MertHayla/Teknofest-tasarim-raporlari/Teknofest Raporları/OTR_Raporu.pdf

Herkese Açık | Public

# TEKNOFEST 2020 ROKET YARIŞMASI Orta İrtifa Kategorisi Ön Tasarım Raporu (ÖTR) Sunuşu

# Albedo Roket Takımı

## Takım Logosu

24 Mart 2021 Çarşamba | 1

2021 TEKNOFEST ROKET YARIŞMASI ÖN TASARIM RAPORU (ÖTR)

# Takım Yapısı Takım

## Logosu

Prof. Dr. Hasan ÇALLIOĞLU Pamukkale Üniversitesi Mekatronik Mühendisliği Bölüm Başkanı Danışman; Hüseyin Mert Arıcı Pamukkale Üniversitesi Mekatronik Mühendisliği Bölümü Takım Lideri İletişim Sorumlusu; Mustafa Kaan Kişmir Pamukkale Üniversitesi Mekatronik Mühendisliği Bölümü Mekanik Koordinatörü; Ramazan Kızılkaya Pamukkale Üniversitesi Mekatronik Mühendisliği Bölümü; Mert Hayla Pamukkale Üniversitesi Mekatronik Mühendisliği Bölümü Elektronik ve Yazılım Koordinatörü; Rıdvan Bakmış Pamukkale Üniversitesi Mekatronik Mühendisliği Bölümü

24 Mart 2021 Çarşamba | 2

2021 TEKNOFEST ROKET YARIŞMASI ÖN TASARIM RAPORU

Herkese Açık | Public Yarışma Roketi Genel

# Görünümü

## Takım Logosu

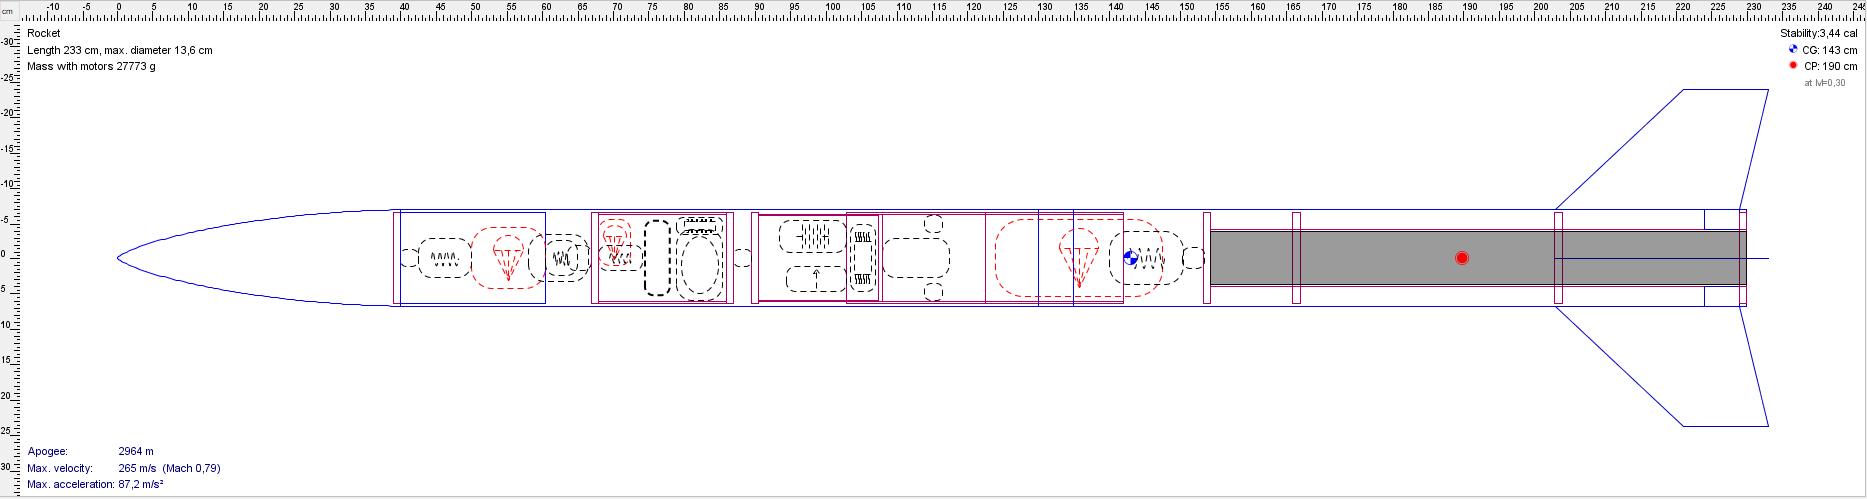
[picture p53: figure]

24 Mart 2021 Çarşamba | 3

2021 TEKNOFEST ROKET YARIŞMASI ÖN TASARIM RAPORU

# Kabul Kriterleri Özeti Takım

## Logosu

24 Mart 2021 Çarşamba | 4

## Tahmin Edilen Uçuş Verileri ve Analizleri

| Ölçü | Yorum
Boy (metre): | 2,33 | OpenRocket ana sayfasından alınmıştır.
Çap (metre): | 0,136 | OpenRocket ana sayfasından alınmıştır.
Roketin Kuru Ağırlığı(kg.): | 16,741 | Motor ve faydalı yük ağırlığı çıkarılmıştır.
Yakıt Kütlesi(kg.): | 4,349 | Motor kataloğundaki detaylardan alınmıştır.
Motorun Kuru Ağırlığı(kg.): | 2,683 | Motor kataloğundaki detaylardan alınmıştır.
Faydalı Yük Ağırlığı (kg.): | 4 | Şartname de bu şekilde belirtilmiştir.
Toplam Kalkış Ağırlığı (kg.): | 27,773 | OpenRocket ana sayfasından alınmıştır.
İtki Tipi: | Kuru Yakıt | Yarışmada kullanılan yakıt tipidir.
| Ölçü | Yorum
Kalkış İtki/Ağırlık Oranı: | 1,65 | Kalkıştaki itkinin kalkıştaki ağırlığa oranıdır.
Rampa Hızı(m/s): | 32,6 | OpenRocket simülasyon sayfasından alınmıştır.
Yanma Boyunca En az Statik Denge Değeri: | 2,29 | Simülasyon verilerinden alınmıştır.
En büyük ivme (g): | 8,899 | Maksimum ivmenin 9.81’e bölünmüş halidir.
En Yüksek Hız(m/s & M): | 265 | OpenRocket simülasyon sayfasından alınmıştır.
Belirlenen İrtifa(m): | 3000 | Yarışma şartnamesinde yer almaktadır.

## Yarışma Roketi Hakkında Genel Bilgiler

Marka : | Cesaroni | İsim: M2020 | Sınıf: | M
Motorun Toplam İtki Değeri(Ns): | | | 8429,4
Marka : | Cesaroni | İsim: M2150 | Sınıf: | M
Motorun Toplam İtki Değeri(Ns): | | | 7455,4

## Motor Seçimleri

2021 TEKNOFEST ROKET YARIŞMASI ÖN TASARIM RAPORU

# Open Rocket Genel Tasarım Takım

## Logosu

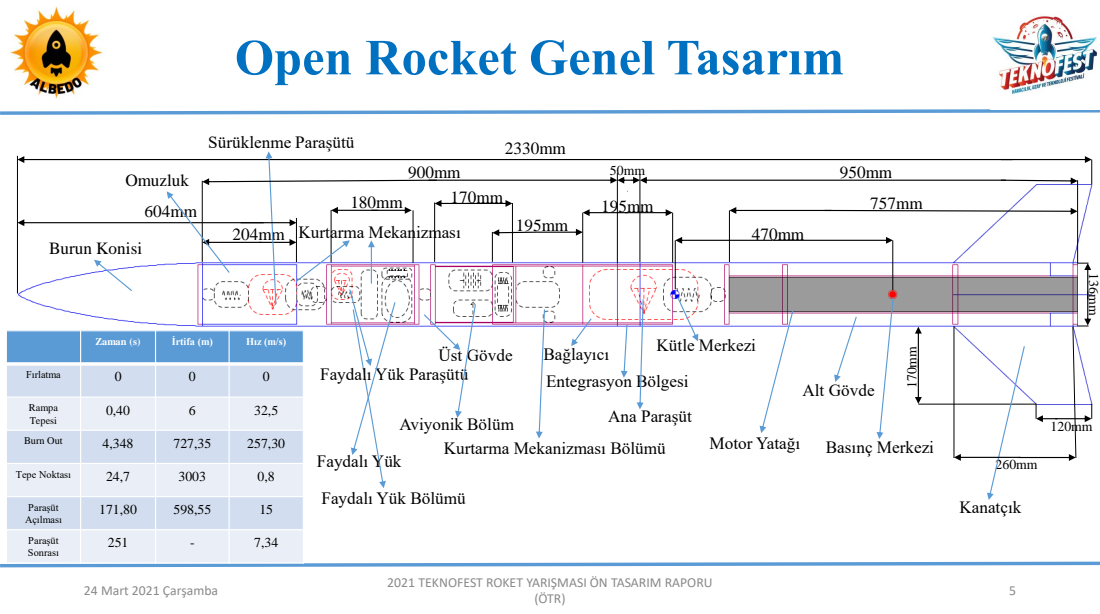
[picture p54: page 5]
24 Mart 2021 Çarşamba; Burun Konisi; Omuzluk; Üst Gövde; Entegrasyon Bölgesi; Alt Gövde; Kanatçık; Kütle Merkezi; Basınç Merkezi; Sürüklenme Paraşütü; Ana Paraşüt; Bağlayıcı; Motor Yatağı; Paraşüt Sonrası; Faydalı Yük; Kurtarma Mekanizması

Zaman (s) | İrtifa (m) | Hız (m/s)

Fırlatma | 0 | 0 | 0

Faydalı Yük Paraşütü

Rampa Tepesi | 0,40 | 6 | 32,5

Aviyonik Bölüm
Kurtarma Mekanizması Bölümü

Burn Out | 4,348 | 727,35 | 257,30

Tepe Noktası | 24,7 | 3003 | 0,8

Faydalı Yük Bölümü

Paraşüt Açılması | 171,80 | 598,55 | 15

2021 TEKNOFEST ROKET YARIŞMASI ÖN TASARIM RAPORU

# Open Rocket/Roket Tasarımı Genel Görünüm Takım

## Logosu

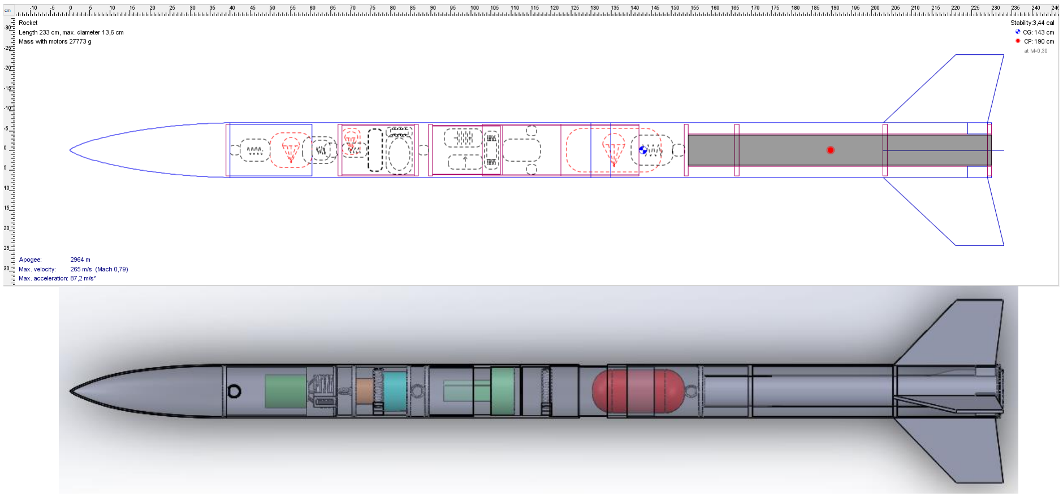
[picture p55: figure]

24 Mart 2021 Çarşamba | 6

2021 TEKNOFEST ROKET YARIŞMASI ÖN TASARIM RAPORU

# Roket Tasarımı Genel Görünüm Takım

## Logosu

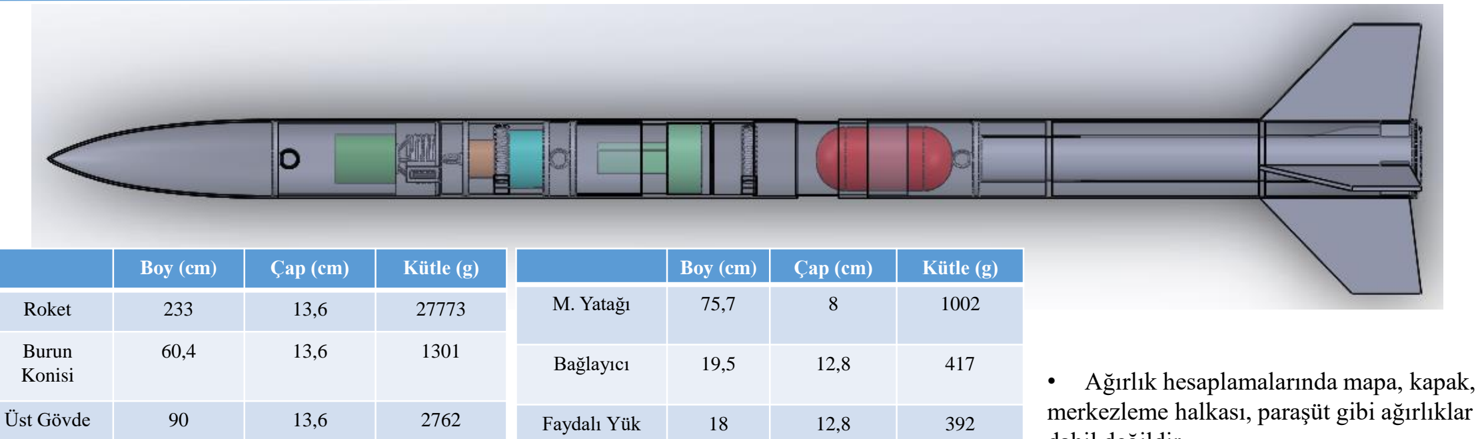
[picture p56: figure]
Boy (cm); Çap (cm); Kütle (g); Roket; Burun Konisi; Üst Gövde; M. Yatağı; Bağlayıcı; Faydalı Yük; • Ağırlık hesaplamalarında mapa, kapak, merkezleme halkası, paraşüt gibi ağırlıklar

24 Mart 2021 Çarşamba | 7

2021 TEKNOFEST ROKET YARIŞMASI ÖN TASARIM RAPORU

Entegrasyon Gövdesi | 5 | 13,6 | 148
Alt Gövde | 95 | 13,6 | 2915
Motor | 75,7 | 7,5 | 7032

Bölümü

Aviyonik Bölüm | 17 | 12,4 | 241
Kurtarma Mekanizması | 19,5 | 12,8 | 417
Kanatçık | 12/26 | 17 | 2900

dahil değildir.

# Motor Seçimi Takım

## Logosu

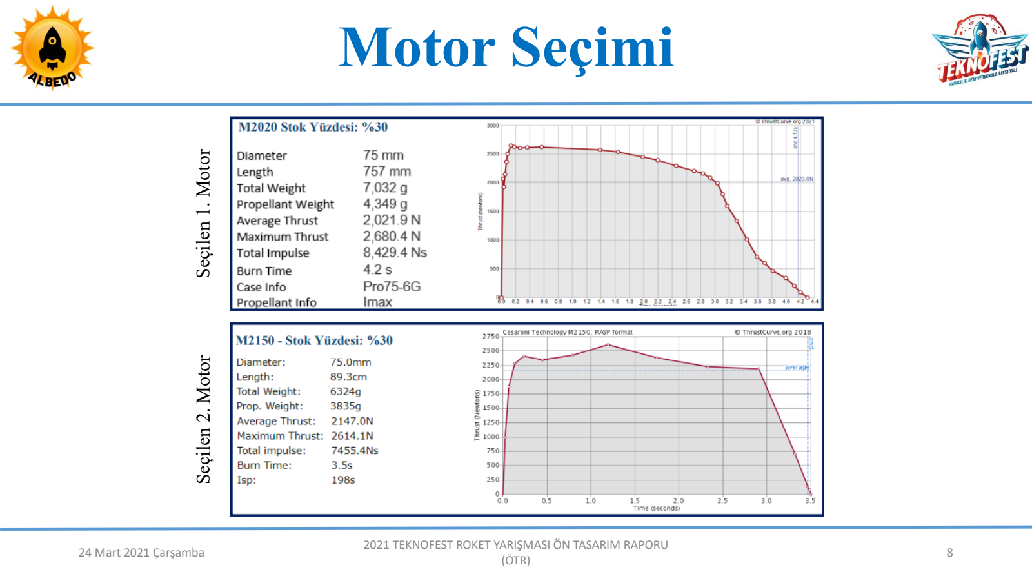
[picture p57: page 8]

24 Mart 2021 Çarşamba

8

2021 TEKNOFEST ROKET YARIŞMASI ÖN TASARIM RAPORU

### Seçilen 1. Motor Seçilen 2. Motor

# 3 Serbestlik Dereceli Uçuş Benzetimi - 1

## Takım

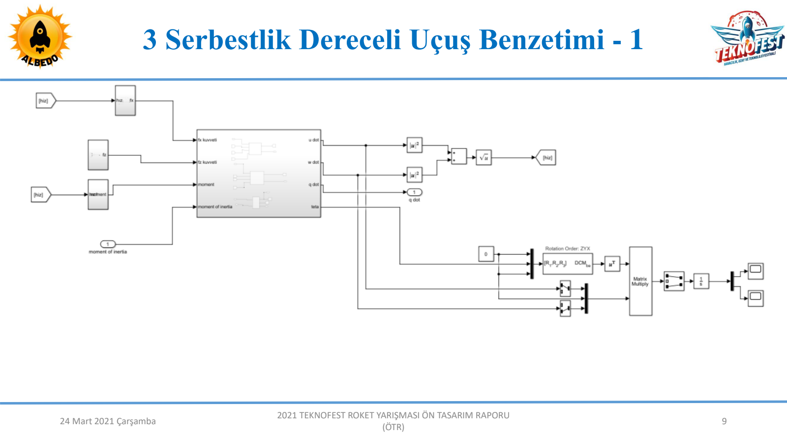
[picture p58: page 9]

## Logosu

24 Mart 2021 Çarşamba | 9

2021 TEKNOFEST ROKET YARIŞMASI ÖN TASARIM RAPORU

# 3 Serbestlik Dereceli Uçuş Benzetimi - 2

## Takım Logosu

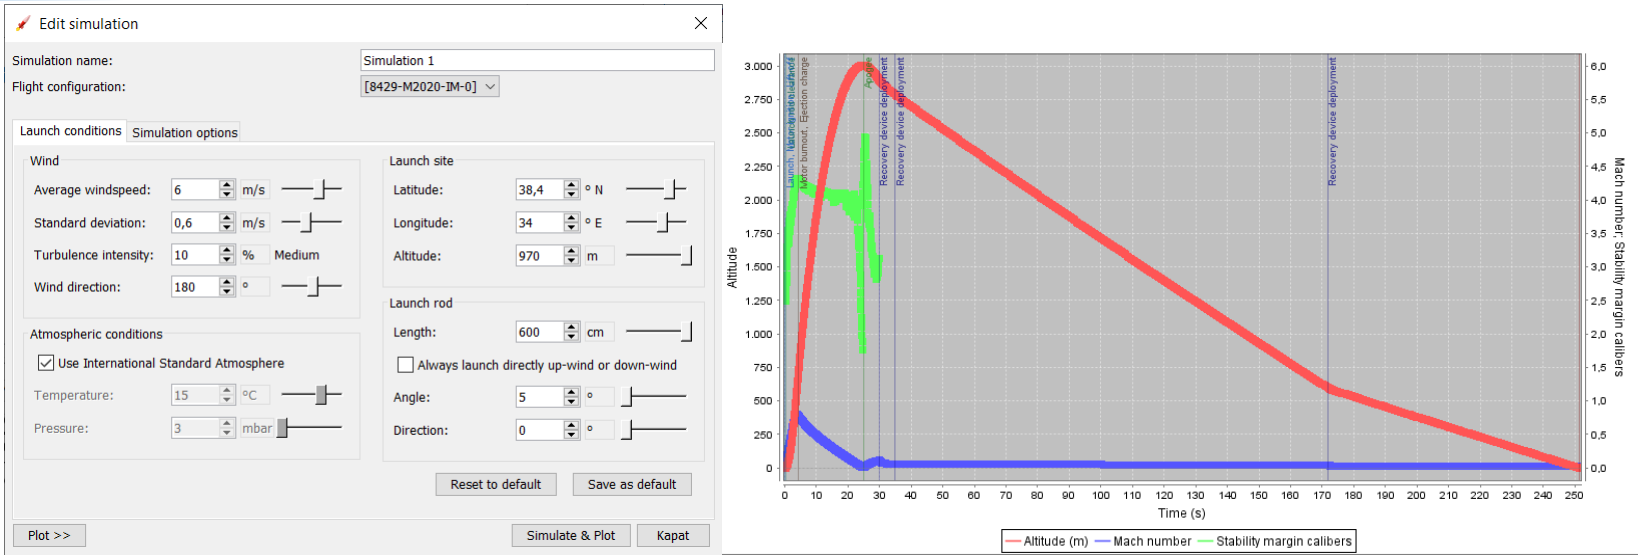
[picture p59: figure]

24 Mart 2021 Çarşamba | 10 2021 TEKNOFEST ROKET YARIŞMASI ÖN TASARIM RAPORU
- Yapılan simülasyonlar şartnamede verilen değerlerle benzetimi yapılmıştır. Değerler girildikten sonra ‘Save as default’
dememize rağmen program kapatılıp tekrar açıldığında Wind
direction, pressure ve direction değerleri değişmektedir.

### Uçuş Simülasyonu

# 3 Serbestlik Dereceli Uçuş Benzetimi - 3

## Takım Logosu

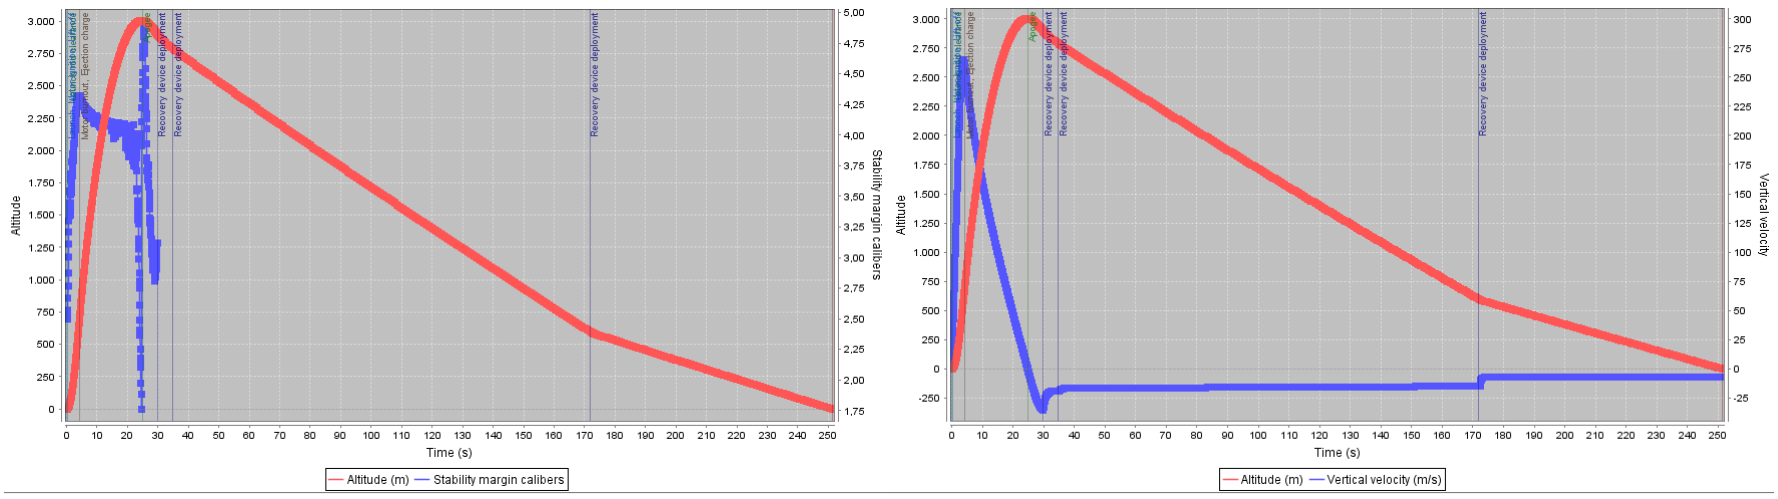
[picture p60: figure]

24 Mart 2021 Çarşamba | 11 2021 TEKNOFEST ROKET YARIŞMASI ÖN TASARIM RAPORU
İrtifa-Stabilite Marjini Simülasyonu | İrtifa-Hız Simülasyonu

## Takım Logosu

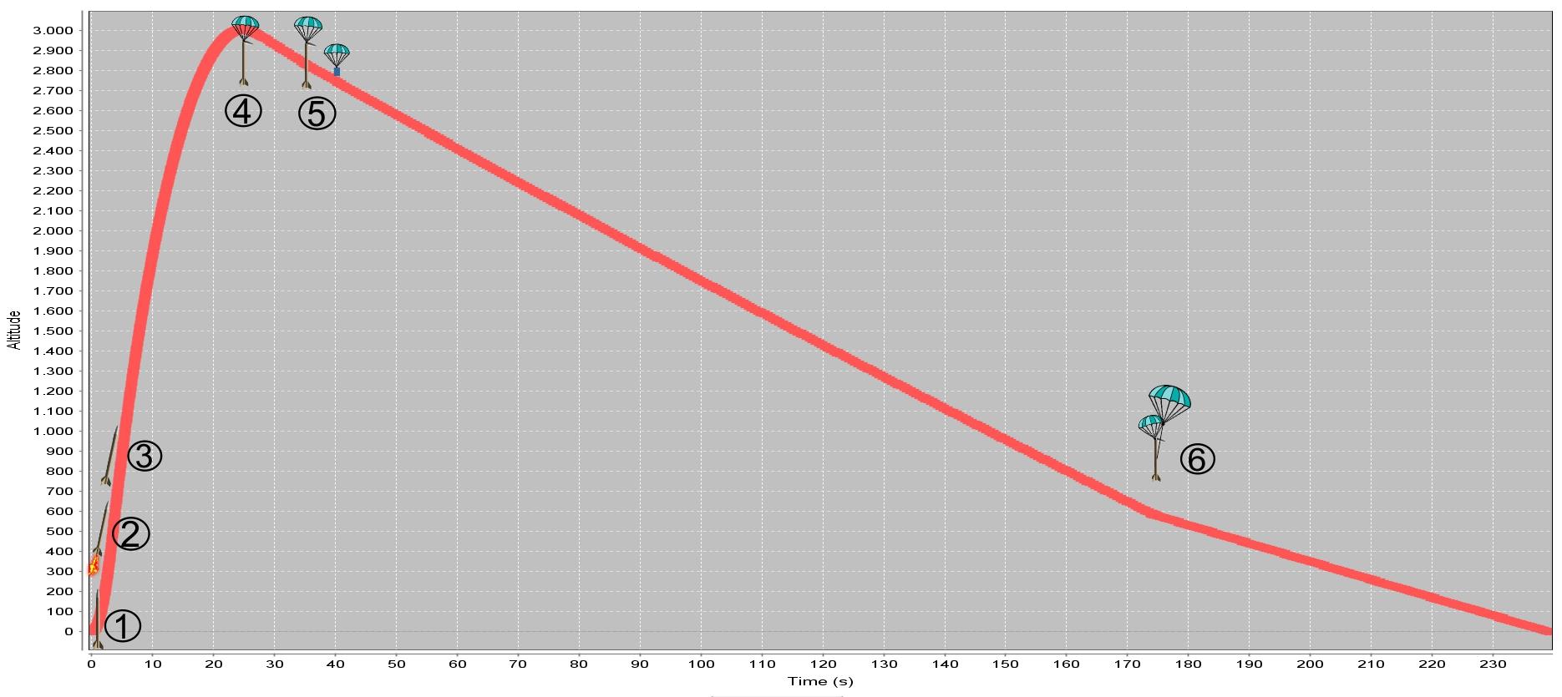
[picture p61: figure]

24 Mart 2021 Çarşamba | 12 2021 TEKNOFEST ROKET YARIŞMASI ÖN TASARIM RAPORU

# Operasyon Konsepti (CONOPS) - 1

Roketin Uçuş Süresince Yükseklik-Zaman Grafiği

| Fırlatma Süreci
1 | Roketin rampaya taşınması
2 | Roketin yakıtın yanması
3 | Roketin yakıtının bitmesi
4 | Roketin sürüklenme paraşütünün açılması
5 | Roketten faydalı yükün ayrılması
6 | Roketin ana paraşütünün açılması

# Operasyon Konsepti (CONOPS) - 2 Takım

## Logosu

24 Mart 2021 Çarşamba | 13 2021 TEKNOFEST ROKET YARIŞMASI ÖN TASARIM RAPORU

Operasyon Süreci
- Roket ilgili takım üyeleri tarafından elle taşınarak yarışma hakemlerinin belirlediği fırlatma rampasına götürülür ve rampaya yerleştirilir.
- Roket fırlatma rampasındayken aviyonik sistem düğme yardımıyla çalıştırılır.
- Yer üssünden veri akışı teyit edilir.
Görev | Görevli
Atış Sorumlusu | Mert Hayla, Hüseyin Mert Arıcı
Atış Alanı Sorumlusu | Rıdvan Bakmış, Mustafa Kaan Kişmir
İniş Alanı Sorumlusu | Ramazan Kızılkaya
- Fırlatma süreci ve uçuş evreleri operasyon konsepti – 1 sayfasında verilmiştir.
- Anlık alınan veriler yer üssündeki bilgisayarın hard diskine ve roketin içerisindeki SD karta depolanacaktır.
- Roketin fırlatma işlemi başarıyla tamamlandıktan sonra yer üssünden roketin GPS konumu anlık takip edilir. Roket inişini yaptıktan sonra iniş alanı sorumlusu yer üssü sorumlusu ile iletişime geçerek roketin konumunu saptar ve kurtarma işlemini gerçekleştirir.
- Roket rampasının eğiminin olduğu doğrultuda 1500-2000m tahmini iniş aralığıdır.

# Kütle Bütçesi Takım

## Logosu

24 Mart 2021 Çarşamba | 14 2021 TEKNOFEST ROKET YARIŞMASI ÖN TASARIM RAPORU
Kütle (g) | Adet
856 | 1
445 | 1
347 | 1
2,58 | 1
50 | 1
138 | 1
3,5 | 1
2762 | 1
50 | 1
150 | 1
300 | 1
50 | 1
347 | 1
10 | 2
112 | 1
150 | 1
150 | 2
4000 | 1
392 | 1
50 | 1
45,1 | 1
3,5 | 1
347 | 2
50 | 1
Entegrasyon Gövdesi | Gövde 148 Karbonfiber 1 Bağlayıcı 417 Alüminyum 1
Alt Gövde Motor | Gövde Fiberglass 2915 1 Mapa 50 Paslanmaz Çelik 1 Ana Paraşüt 336 Yırtılmaz Naylon 1 Ana Paraşüt Kordonu 56 Boru Şeklinde Naylon 1 Kanatçık Alüminyum 726,5 4 Motor Yatağı 1002 Alüminyum 1 Motor Kapağı 347 Alüminyum 1 Merkezleme Halkası 160 Fiberglass 2 Motor Alt Kapağı Fiberglass 238 1 Motor 7032 ? 1
Sürüklenme Paraşütü | Yırtılmaz Naylon

Roket Ürün Ağacı

Alt Sistem | Komponent | Malzeme

Burun

| Burun Konisi | Fiberglass
| Omuzluk | Fiberglass
| Kapak | Alüminyum
| Şok Kordonu | Elastik Kordon
| Mapa | Paslanmaz Çelik
| Sürüklenme Paraşütü Kordonu | Örgülü Naylon
Üst Gövde | Gövde | Fiberglass
| Mapa | Paslanmaz Çelik
Mekanizması | Kurtarma Mekanizması 1 | Fiberglass

Aviyonik Bölüm

| Aviyonik | ?
| Batarya | Endüstriyel Alkalin
| Altimetre | ?
| Kapak | Alüminyum
| Pin | ?
Kurtarma | Kapak | Fiberglass
| Kurtarma Mekanizması 2 | Fiberglass
| Faydalı Yük | Paslanmaz Çelik
| Faydalı Yük Tüpü | Fiberglass
Faydalı Yük | Faydalı Yük Aviyonik | ?
Bölümü | Faydalı Yük Paraşütü | Yırtılmaz Naylon
| Şok Kordonu | Örgülü Naylon
| Kapak | Alüminyum
| Mapa | Paslanmaz Çelik

# Roket Alt Sistem Detayları

## Takım Logosu

24 Mart 2021 Çarşamba | 15 2021 TEKNOFEST ROKET YARIŞMASI ÖN TASARIM RAPORU

# Burun Konisi & Kanatçık Mekanik Görünüm

## Takım

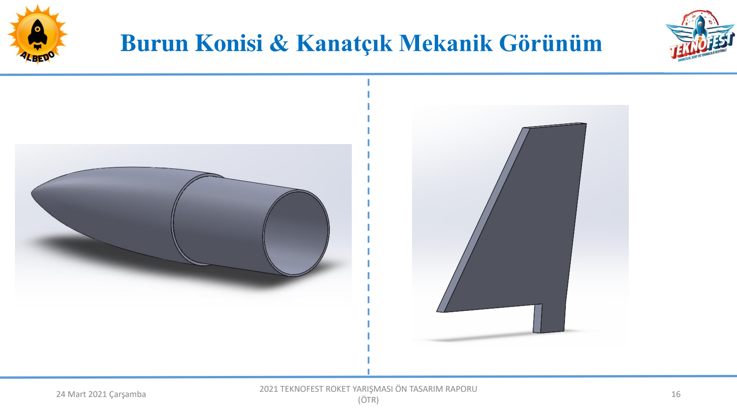
[picture p62: page 16]

## Logosu

24 Mart 2021 Çarşamba | 16 2021 TEKNOFEST ROKET YARIŞMASI ÖN TASARIM RAPORU

# Burun Konisi – Detay Takım

## Logosu

24 Mart 2021 Çarşamba | 17 2021 TEKNOFEST ROKET YARIŞMASI ÖN TASARIM RAPORU
Özellik | | Kapsam
CAD Modeli | :
Fiziksel Özellikler | : | Burun konisi şekli, seçilen burun konisinin parametreleri, boyutları, kütlesi ve burun konisinin üretileceği malzeme yandaki görselde verilmiştir.
Malzeme Bilgileri | : | Alternatif malzeme olarak karbonfiber düşünülmektedir. Değerleri tablodaki gibidir.
Malzeme | Yoğunlu k (g/cm^3) | Tokl uk | Çekme Mukavemeti (MPa) | Şekillendirileb ilirlik | Isı Dayanımı
Fiberglass | 1,85 | İyi | 3448 | Kolay | Yüksek
Karbonfiber | 1,78 | İyi | 4300 | Kolay | Yüksek
Üretim Yöntemleri | : | Prepreg dediğimiz önceden reçineye emdirilmiş hazır kumaşların kullanılmasına veya elyaf sarma yönteminin kullanılmasına karar verilmiştir.

604mm

400mm

128mm
136mm
- Üretimde fiberglass seçilmiştir çünkü malzeme dayanımı, şekillendirilebilirliği gibi faktörler göz önünde bulundurulmuştur.

Özellik | 15
CAD Modeli | : | 120mm 260mm
Fiziksel Özellikler | : | Fiberglass 1,85 3448 72,4 ²⁸mm Roket kanatçığının boyutları, kütlesi, kanatçığın üretileceği malzeme ve roket gövdesi içine girecek kısmın ölçüleri OpenRocket programından alınan görselde gözükmektedir.
Malzeme Bilgileri | : | Alternatif malzeme olarak fiberglass düşünülmektedir. Değerleri tablodaki gibidir.
Malzeme | Yoğunluk (g/cm^3) | Çekme Dayanımı (MPa) | Elastite Modülü (GPa)
Alüminyum | 2,70 | 572 | 72
Üretim Yöntemleri | :

Kanatçık tasarımı özgün üretim olmasından dolayı CAD çizimi çıkarılarak CNC kesim işleme aktarılmasıyla 8mm et kalınlığındaki alüminyum levhadan üretimi yapılması planlanmaktadır.

# Kanatçık – Detay Takım

## Logosu

24 Mart 2021 Çarşamba | 18 2021 TEKNOFEST ROKET YARIŞMASI ÖN TASARIM RAPORU

50mm

170mm

- Üretimde alüminyum tercih edilmiştir çünkü malzemenin yoğunluğu, şartname için gerekli şartları sağlamakta yardımcı olmuştur.

# Faydalı Yük Mekanik Görünüm Takım

## Logosu

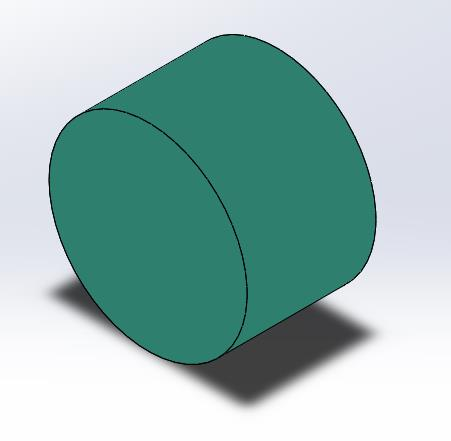
[picture p63: figure]

24 Mart 2021 Çarşamba | 19 2021 TEKNOFEST ROKET YARIŞMASI ÖN TASARIM RAPORU

# Faydalı Yük - Detay Takım

## Logosu

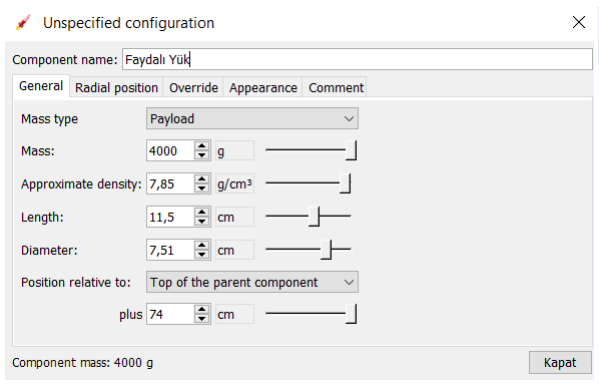
[picture p64: figure]
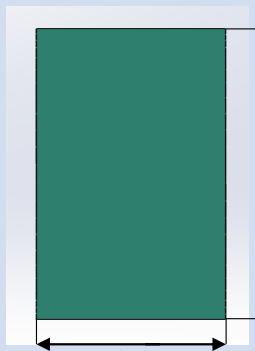
[picture p65: figure]

24 Mart 2021 Çarşamba | 20 2021 TEKNOFEST ROKET YARIŞMASI ÖN TASARIM RAPORU
Özellik | Kapsam
CAD Modeli | :
Fiziksel Özellikler | : | Faydalı yükün herhangi bir işlevi bulunmamaktadır. Faydalı yük ağırlığı, yoğunluğu ve boyutları yandaki görselde görüldüğü gibidir.
Malzeme Bilgileri | : | Roketin yoğunluğu ve boyutları baz alındığında herhangi bir alternatif malzemeye gerek duyulmamıştır. Faydalı yük üretiminde paslanmaz çelik kullanılacaktır.
Üretim Yöntemleri | : | Faydalı yükün üretimi CNC torna işleme merkezinde, paslanmaz çelik malzemeden üretimi planlanmaktadır.

Faydalı Yükün Ayrılması
Sürüklenme paraşütü açıldıktan 10 saniye sonra aviyonik sistem yay mekanizmasını devreye sokar ve faydalı yük roketten dışarı bırakılır.
Faydalı Yükün Bulunması
Faydalı yüke bağlı buzzer ve GPS yardımıyla faydalı yükün yeri tespit edilir ve kurtarılır.
Neden Paslanmaz Çelik Seçildi ?
Faydalı yük boyutlarını bu şekilde tutmak için yoğunluğuna bakılarak çelikten yapılması kararlaştırılmıştır

100mm

65mm

# Gövde Parçaları & Gövde Montaj Parçaları (YAPISAL) Mekanik Görünüm

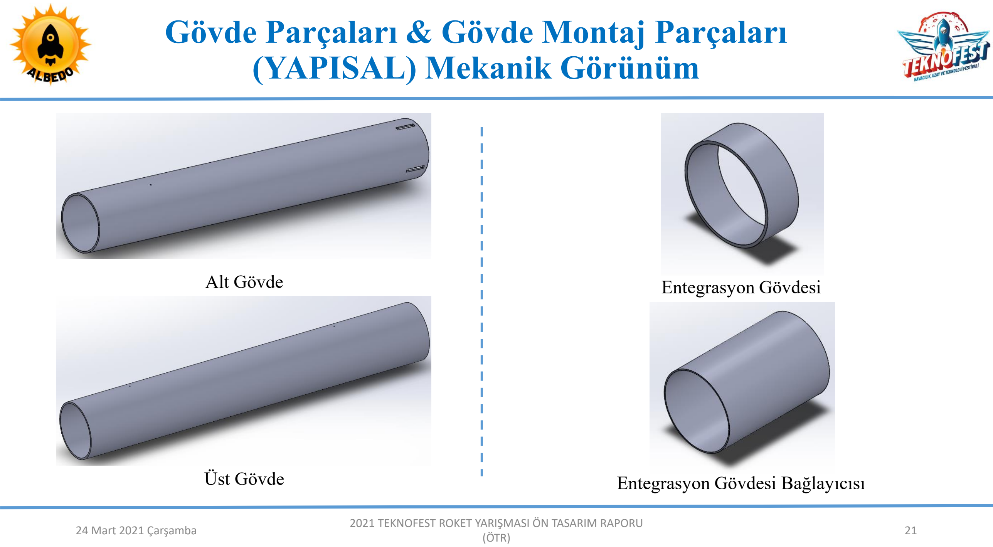
[picture p66: page 21]

## Takım Logosu

24 Mart 2021 Çarşamba | 21 2021 TEKNOFEST ROKET YARIŞMASI ÖN TASARIM RAPORU

### Alt Gövde

### Üst Gövde

### Entegrasyon Gövdesi

### Entegrasyon Gövdesi Bağlayıcısı

# Yapısal – Gövde/Gövde İçi Yapısal Destekler (Montaj Elemanları) - 1

## Takım Logosu

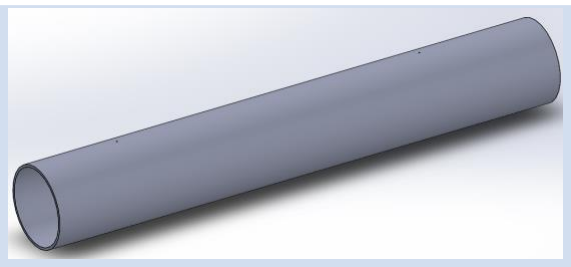
[picture p67: figure]
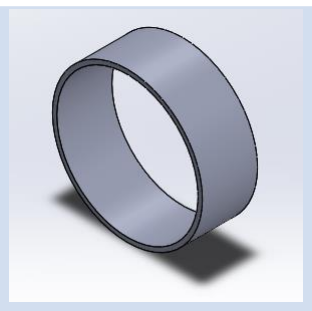
[picture p68: figure]
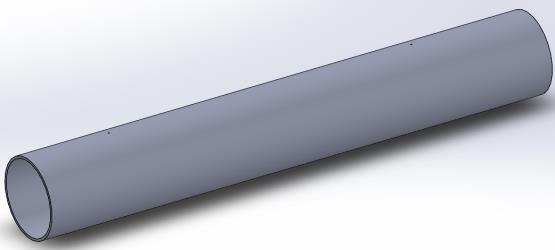
[picture p69: figure]

24 Mart 2021 Çarşamba | 22 2021 TEKNOFEST ROKET YARIŞMASI ÖN TASARIM RAPORU
Özellik | | Kapsam
CAD Modeli | :
Fiziksel Özellikler | : | Roket gövdesi, üst gövde, entegrasyon gövdesi ve alt gövdeden oluşmaktadır. Üst gövde 900mm uzunluğa, 136mm dış çapa, 4mm et kalınlığına sahiptir ve kütlesi 2,762 kg’dır. Entegrasyon gövdesi 50mm uzunluğa, 136mm dış çapa, 4mm et kalınlığına sahiptir ve kütlesi 0,148 kg’dır. Alt gövde ise 950mm uzunluğa, 136mm dış çapa, 4mm et kalınlığına sahiptir ve kütlesi 2,915 kg’dır.
Malzeme Bilgileri | : | Üst ve alt gövde için fiberglass, entegre gövdesi üretimi için karbonfiber malzeme kullanılacaktır. Malzemeler şartnamede belirtildiği gibi kompozit malzemelerden seçilmiştir. Malzemelerin bu şekilde seçilmesinin bir diğer nedeni ise roketin stabil bir şekilde uçuşunu sağlamaktadır. Kompozit malzemeler kolay şekillendirilebilir, dayanıklı, hafif ve tasarım kolaylığı olan
| (g/cm^3) | Tokluk | Çekme Mukavemeti (MPa) | Şekillendirilebilirlik | Isı Dayanımı
Fiberglass | 1,85 | İyi | 3448 | Kolay | Yüksek
Karbonfiber | 1,78 | İyi | 4300 | Kolay | Yüksek

malzemelerdir.

Üretim
Yöntemleri :

Prepreg dediğimiz önceden reçineye emdirilmiş hazır kumaşların kullanılmasına veya elyaf sarma yönteminin kullanılmasına karar verilmiştir.

- | Roketimizde | basınç
sensöründen verimli bir veri almak için her biri 3mm çapa sahip 3 tane delik açılmıştır.
Bunlardan | biri | burundan
hemen | önceki | gövdenin
bitim yerine, diğeri aviyonik sistemlerin olduğu yere ve
son | olarak | da | motor
kapağının bulunduğu yere
delikler açılmıştır.
- | Roket | motoru, | motor
yatağının | içine | girerek
montajlanacaktır. | Motor
yatağını | sabitleyen eleman
merkezleme | halkası
olacaktır. | Malzeme | Yoğunluk

# Yapısal – Gövde/Gövde İçi Yapısal Destekler (Montaj Elemanları) - 2

## Takım Logosu

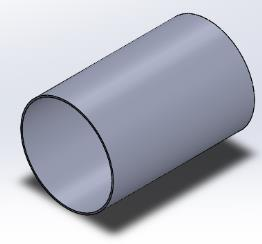
[picture p70: figure]
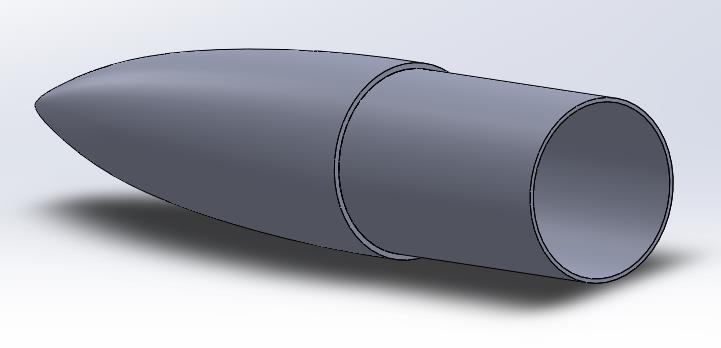
[picture p71: figure]
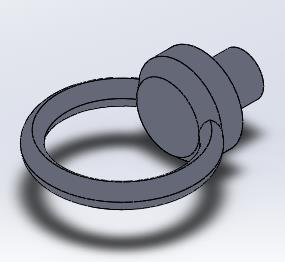
[picture p72: figure]

24 Mart 2021 Çarşamba | 23 2021 TEKNOFEST ROKET YARIŞMASI ÖN TASARIM RAPORU
Özellik | | Kapsam
CAD Modeli | :
Fiziksel Özellikler | : | Entegrasyon gövde bağlayıcısı 195mm uzunluğa, 124mm dış çapa, 2mm et kalınlığına ve 0,417 kg ağırlığa sahiptir. Burun konisi omuzluğu 204mm uzunluğa, 128mm dış çapa, 3mm et kalınlığına ve burun ile birlikte toplam 1,301 kg ağırlığa sahiptir. Merkezleme halkası 11mm uzunluğa, 128mm dış çapa, 24mm et kalınlığına ve 0,160 kg ağırlığa sahiptir. Mapa dövülmüş çelikten , şartnameye göre imal edilecektir.
Malzeme Bilgileri | : | Entegrasyon gövdesi bağlayıcısı üretimi için alüminyum malzeme, burun konisi omuzluğu üretimi için burun konisi ile aynı malzeme yani fiberglasstan ve merkezleme halkası üretimi için de fiberglass tercih edilmiştir. Üretiminin kolay olması, dayanıklı olmaları ve roket stabilitesini sağlamaları nedeniyle malzeme seçimi bu şekilde yapılmıştır.
Malzeme | Yoğunluk (g/cm^3) | Tokluk | Çekme Mukavemeti (MPa) | Şekillendirilebilirlik | Isı Dayanımı
Alüminyum | 2.7 | İyi | 572 | Kolay | Orta
Fiberglass | 1.85 | İyi | 3448 | Kolay | Yüksek
Üretim Yöntemleri | : | Üretimi kompozit malzemeden olacak parçalar için prepreg dediğimiz önceden reçineye emdirilmiş hazır kumaşların kullanılmasına veya elyaf sarma yönteminin kullanılmasına karar verilmiştir. Üretimi alüminyum malzemeden olan parçalar için CNC torna işleme merkezinde üretimi yapılacaktır.

# Yapısal – Gövde/Gövde İçi Yapısal Destekler (Montaj Elemanları) - 3

## Takım Logosu

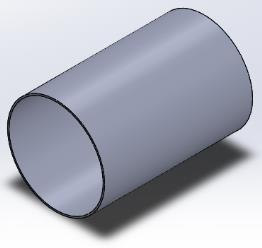
[picture p73: figure]
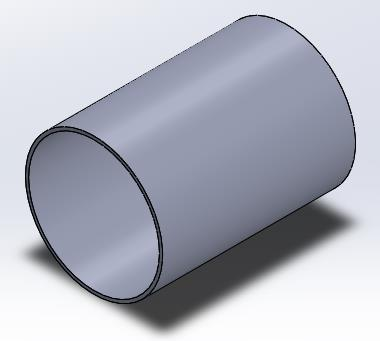
[picture p74: figure]
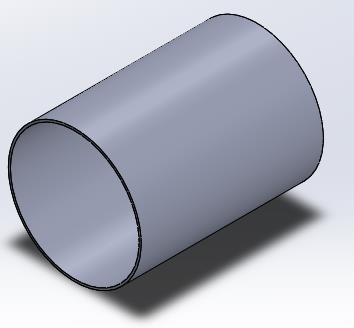
[picture p75: figure]

24 Mart 2021 Çarşamba | 24 2021 TEKNOFEST ROKET YARIŞMASI ÖN TASARIM RAPORU
Özellik | | Kapsam
CAD Modeli | :
Fiziksel Özellikler | : | Faydalı yük tüpü 180mm uzunluğa, 128mm dış çapa, 3mm et kalınlığına ve 0,392 kg ağırlığa sahiptir. Aviyonik kısım 170mm uzunluğa, 124mm dış çapa, 2mm et kalınlığına ve 0,241 kg ağırlığa sahiptir. Açılma mekanizması 195mm uzunluğa, 128mm dış çapa, 2mm et kalınlığına ve 0,417 kg ağırlığa sahiptir.
Malzeme Bilgileri | : | Faydalı yük tüpü üretimi için fiberglass malzeme, aviyonik kısım üretimi için fiberglasstan ve açılma mekanizması üretimi için ise alüminyum tercih edilmiştir. Üretiminin kolay olması, dayanıklı olmaları ve roket stabilitesini sağlamaları nedeniyle malzeme seçimi bu şekilde yapılmıştır.
Malzeme | Yoğunluk (g/cm^3) | Tokluk | Çekme Mukavemeti (MPa) | Şekillendirilebilirlik | Isı Dayanımı
Alüminyum | 2.7 | İyi | 572 | Kolay | Orta
Fiberglass | 1.85 | İyi | 3448 | Kolay | Yüksek

Üretim Yöntemleri

:

Üretimi kompozit malzemeden olacak parçalar için prepreg dediğimiz önceden reçineye emdirilmiş hazır kumaşların kullanılmasına veya elyaf sarma yönteminin kullanılmasına karar verilmiştir. Üretimi alüminyum malzemeden olan parçalar için CNC torna işleme merkezinde üretimi yapılacaktır.

# Motor Bölümü Mekanik Görünüm & Detay

## Takım Logosu

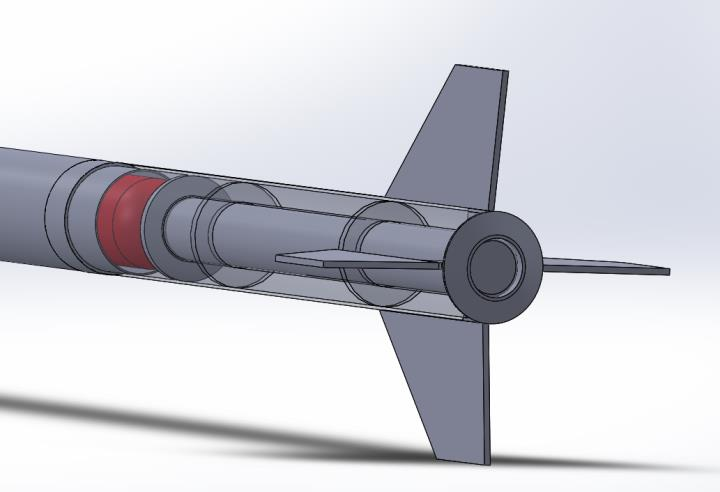
[picture p76: figure]
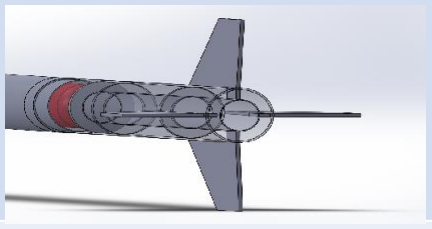
[picture p77: figure]

24 Mart 2021 Çarşamba | 25 2021 TEKNOFEST ROKET YARIŞMASI ÖN TASARIM RAPORU
Özellik | Kapsam
CAD Modeli | :

Yandaki CAD görselinde motor kısmı görülmektedir. Hakemler tarafından bize verilecek olan motor için 80mm çapında bir motor yatağı bulunmaktadır. Görsel de de görüldüğü üzere motor arka kapağı çıkarıldığında direkt motor yatağı başlamaktadır. Motor yatağına yerleştirildikten sonra motor kapağı yerine monte edilir ve roket motorunun hareket etmesi engellenir ve olası bir kazanın önünne geçilmiş olur. Alttaki görsel de de motor kapağı ve motor çıkarılmıştır.

Fiziksel Özellikler | : | Motor yatağı 80mm dış çapa sahiptir. 2mm et kalınlığından oluşan motor yatağının alüminyumdan üretilmesi planlanmaktadır. Motor yatağı merkezleme halkaları ile birlikte yerine sabitlenmiştir. Motor kapağının iç çapı 72mm olarak üretimi planlanmaktadır. Bu şekilde üretilecek bir kapak, roket motorunun motor yatağında sabit kalmasını sağlayacaktır. Motor yatağı, motor, alt gövde, motor ön ve arka kapağının toplam ağırlığı 11,854 kg’dır.
Malzeme Bilgileri | : | Roketin bu kısmında alt gövde fiberglass, motor yatağı alüminyum, merkezleme halkaları fiberglass, motor ön kapağı alüminyum, motor arka kapağı fiberglass malzemeden üretimi planlanmaktadır.
Üretim Yöntemleri | :

Üretimi kompozit malzemeden olacak parçalar için prepreg dediğimiz önceden reçineye emdirilmiş hazır kumaşların kullanılmasına veya elyaf sarma yönteminin kullanılmasına karar verilmiştir. Üretimi alüminyum malzemeden olan parçalar için CNC torna işleme merkezinde üretimi yapılacaktır.

# Motor Bölümü Mekanik Görünüm & Detay

## Takım Logosu

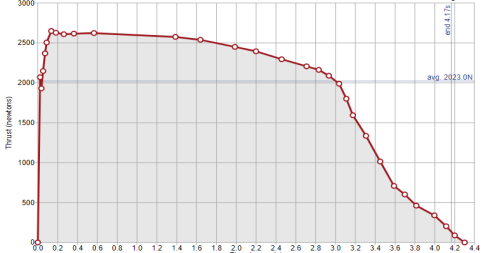
[picture p78: figure]

24 Mart 2021 Çarşamba | 26 2021 TEKNOFEST ROKET YARIŞMASI ÖN TASARIM RAPORU

Motor İtki-Zaman Grafiği

Time (s)

# İkinci/Alternatif Motor Seçimi Takım

## Logosu

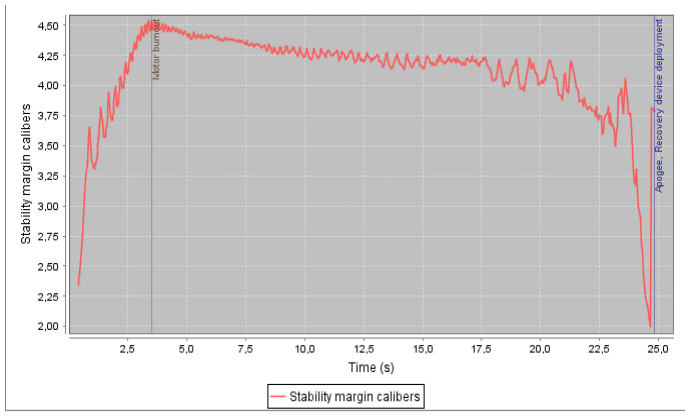
[picture p79: figure]
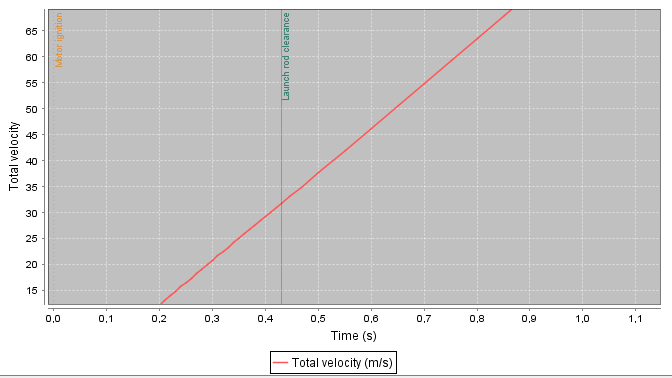
[picture p80: figure]

24 Mart 2021 Çarşamba | 27 2020 TEKNOFEST ROKET YARIŞMASI KRİTİK TASARIM RAPORU
(KTR)
- İkinci/Alternatif motor seçimi olarak M2150 motoru seçilmiştir.
- İlk seçilen M2020 motoruyla çapları aynıdır fakat M2150 motoru uzunluğu 89,3cm iken 75,7cm’dir.
Bu nedenle motor yatağı uzunluğu değişmek zorunda kalmış ve buna bağlı olarak roket içi yerleşimi biraz daha
ön tarafa doğru kaymıştır.
- M2150 için tasarlanan roketteki burun konisi ve kanatçığında geometrik değişiklikler yapıldı.
- Rokette bulunan bazı kapakların malzeme türünde değişikliğe gidildi ve roketin az bir miktar hafifletilmesi sağlandı.
- Statik marjin ve rampadan çıkış hızıyla ilgili grafikler alt tarafta verildiği gibidir.

# Kurtarma Sistemi Mekanik Görünüm Takım

## Logosu

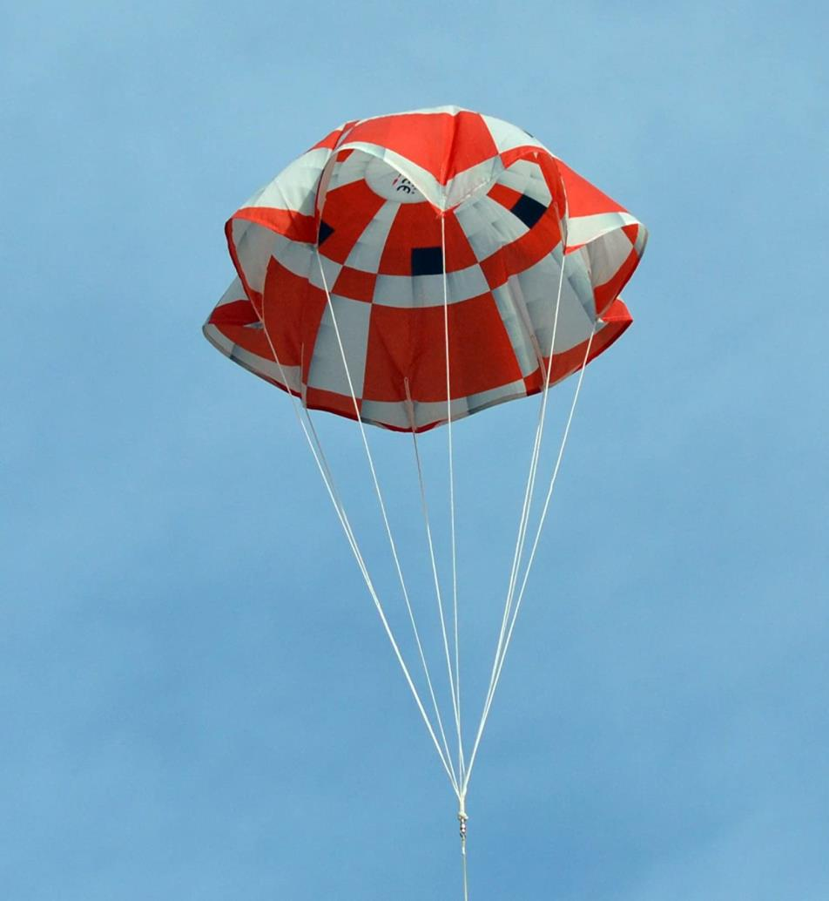
[picture p81: figure]
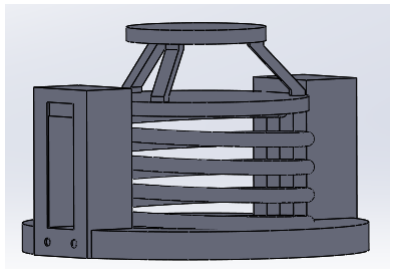
[picture p82: figure]
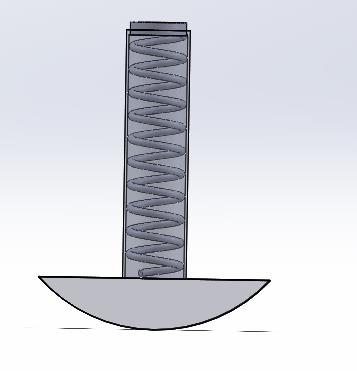
[picture p83: figure]

24 Mart 2021 Çarşamba | 28 2021 TEKNOFEST ROKET YARIŞMASI ÖN TASARIM RAPORU

# Kurtarma Sistemi – Paraşüt Açma Sistemi -1 Takım

## Logosu

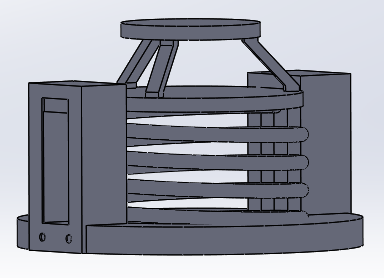
[picture p84: figure]

24 Mart 2021 Çarşamba | 29 2021 TEKNOFEST ROKET YARIŞMASI ÖN TASARIM RAPORU
Özellik | | Kapsam
CAD Modeli | :
Fiziksel Özellikler | : | Burun için tasarlanan paraşüt açma sisteminin çapı 124mm, uzunluğu 70mm ve ağırlığı 0,150 kg olarak belirlenmiştir. Faydalı yük ve ana paraşüt için tasarlanan paraşüt açma sisteminin ise dikey uzunluğu 118mm, yatay uzunluğu alt kısmı roket gövdesine oturacak şekilde 25mm, ağırlığı 0,120 kg olarak belirlenmiştir.
Malzeme Bilgileri | : | Veri akışının sağlanması gibi durumlarda aksaklık olmaması nedeniyle paraşüt açma sistemi fiberglass malzemeden üretimi planlanmaktadır.
Malzeme | Yoğunluk (g/cm^3) | Tokluk | Çekme Mukavemeti (MPa) | Şekillendirilebilirlik | Isı Dayanımı
Fiberglass | 1,85 | İyi | 3448 | Kolay | Yüksek
Karbonfiber | 1,78 | İyi | 4300 | Kolay | Yüksek
Üretim Yöntemleri | :

Uygun yayın bulunaması durumunda özel üretim yay kullanılacaktır. Sistem kompozit malzemeden olacağından Üretimi kompozit malzemeden olacak parçalar için prepreg dediğimiz önceden reçineye emdirilmiş hazır kumaşların kullanılmasına veya elyaf sarma yönteminin kullanılmasına karar verilmiştir.

# Kurtarma Sistemi – Paraşüt Açma Sistemi - 2

## Takım Logosu

24 Mart 2021 Çarşamba | 30 2021 TEKNOFEST ROKET YARIŞMASI ÖN TASARIM RAPORU
Yaylı Sistem | Barut | Karbondioksit Tüpü
Sınırsız tasarıma sahiptir. | Roketi kurtarma şansı çok yüksektir. | Hazır olarak satın alınabiliyor.
Yapılan testlerde malzeme harcamadan tekrar tekrar test yapılabilir. | Maliyeti azdır. | Patlama sonucu ısı vermiyor. Soğuk gaz salınımı mevcut.
Sızdırmaz bir sisteme gerek yok. | Malzemeleri kolayca tedarik edilebiliyor. | Sistem paraşüt ve iplere zarar vermiyor.
Sistemde gaz olmadığı için gazı yönlendirmek zorunda olunmuyor. | Sistemi üretip hazır hale getirmek için fazla bir zaman ayırmaya gerek yok. | Sistem patladıktan sonra paraşüte ve paraşüt iplerine zarar vermez.
Yaylı Sistem | Barut | Karbondioksit Tüpü
Üretim öncesi kütle tahmini yapmak zordur. | Sistemin sızdırmazlığını sağlamak gerek. | Sistemin sızdırmazlığını sağlamak gerek.
Tasarımı ve hesaplaması dikkatle yapılmalıdır. | Şartlar gereği roketi, barutu en son entegre edilecek şekilde tasarlamalı. | Tüpler tek kullanımlık olduğundan maliyetlidir.
Barutlu sisteme göre pahalıdır. | Güvenlik açısından risklidir. | Hazneler metalden üretildiği için roketin ağırlığını artırır.
Barutlu sisteme göre daha ağırdır. | Isı yaydığından paraşütü yakabilir. | Tüplerin oturacağı hazneler ve tüpü delecek parça için işlenilmesi gereken parçalara ihtiyaç olacak.
- Yandaki tabloda kurtarma sistemi tiplerinin avantaj ve dezavantajları yer almaktadır.
- Tasarladığımız rokette yaylı mekanik sistem kullanılacaktır.
- Tasarlanan rokette yaylı mekanik sistem kullanılacak olmasının en büyük sebebi sistemin güvenli olmasıdır. Belli bir gaza yön vermek zorunda kalmamak ve roketimize daha uygun olacağını düşündüğümüzden dolayı yaylı mekanik sistem kullanılacaktır.

### Avantajlar Dezavantajlar

# Kurtarma Sistemi – Paraşüt Açma Sistemi -3

## Takım Logosu

24 Mart 2021 Çarşamba | 31 2021 TEKNOFEST ROKET YARIŞMASI ÖN TASARIM RAPORU

Kurtarma Sistemi Aktivasyonu:
- Basınç sensöründen gelen irtifa verisi ve ivme sensöründen gelen veriler istenilen değerlere ulaştığında servo motorlar yardımıyla ilk önce sürüklenme paraşütü sonra faydalı yük en son olarak da ana paraşüt mekanizması aktif olacaktır.

Kurtarma Stratejisi ve Aşamaları :
1. Roket istenilen irtifaya (apogee) geldiğinde kurtarma mekanizması aktif olacaktır.
2. Kurtarma sistemi aktif olduktan sonra roket güvenli bir şekilde inişe geçer ve tahmini iniş bölgesine ulaşır. Roketin fırlatmadan itibaren canlı olarak konum takibi GPS sinyali ile yapılır.
3. Roket yere güvenli iniş yaptıktan sonra GPS verisinden yararlanılarak roketin konumu tespit edilir ve kurtarma ekibi yola çıkar.
4. Kurtarma ekibi tespit edilen konuma ulaşınca buzzerdan gelen ses ile roket ve faydalı yük bulunup kurtarılır.

Parçanın işlevi:
- Sistemde 3 adet yay mekanizması bulunmaktadır.
- Birinci yay mekanizması burun konisinin açılıp sürüklenme paraşütünün dışarı çıkmasını sağlar.
- İkinci yay mekanizması faydalı yük kapağının açılmasını ve faydalı yükün bırakılmasını sağlar.
- Üçüncü yay mekanizması ana paraşüt kapağının açılmasını ve ana paraşütün dışarı fırlatılmasını sağlar.

Alt Sistemlerin İşlevi:
- Kurtarma sisteminde bulunan servo motor yay mekanizmasının aktivasyonunda kullanır.

# Kurtarma Sistemi – Paraşüt Açma Sistemi - 4 Takım

## Logosu

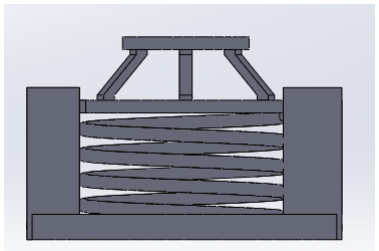
[picture p85: figure]
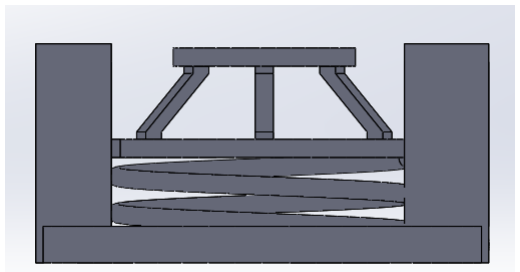
[picture p86: figure]
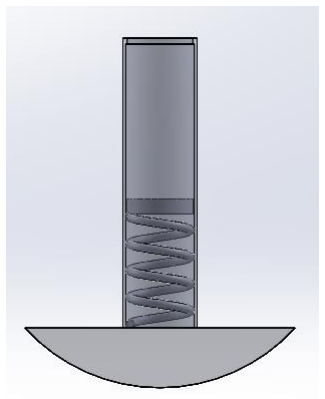
[picture p87: figure]
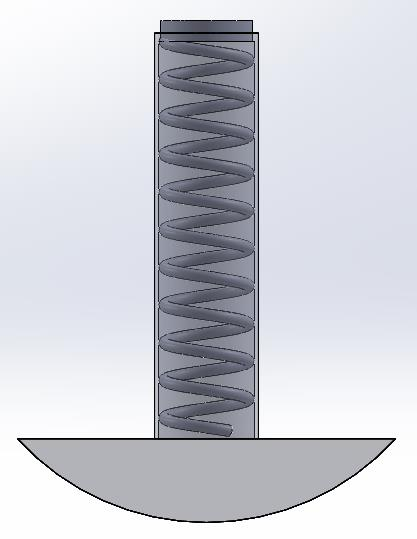
[picture p88: figure]

24 Mart 2021 Çarşamba | 32 2021 TEKNOFEST ROKET YARIŞMASI ÖN TASARIM RAPORU
- Roketimizde biri yatay diğeri dikey iki farklı yaylı mekanik kurtarma mekanizması mevcuttur.
- Roket tepe noktasına geldiğinde aviyonik sistem servo motorlara sinyal gönderir ve yaylar paraşütleri belirtilen sırayla açmaya başlar.
- Yandaki görselde görüldüğü üzere aviyonik sistem servo motorlara sinyal gönderdikten sonra yaylı mekanik sistem birinci görseldeki konumdan ikinci görseldeki konuma geçer ve dikey mekanizma burun konisinin açılmasını, yatay mekanizmalar ise faydalı yük ve ana paraşüt için olan kapakların paraşüt açılma sırasına göre açılmasını sağlar.

# Kurtarma Sistemi – Paraşütler - 1

## Takım Logosu

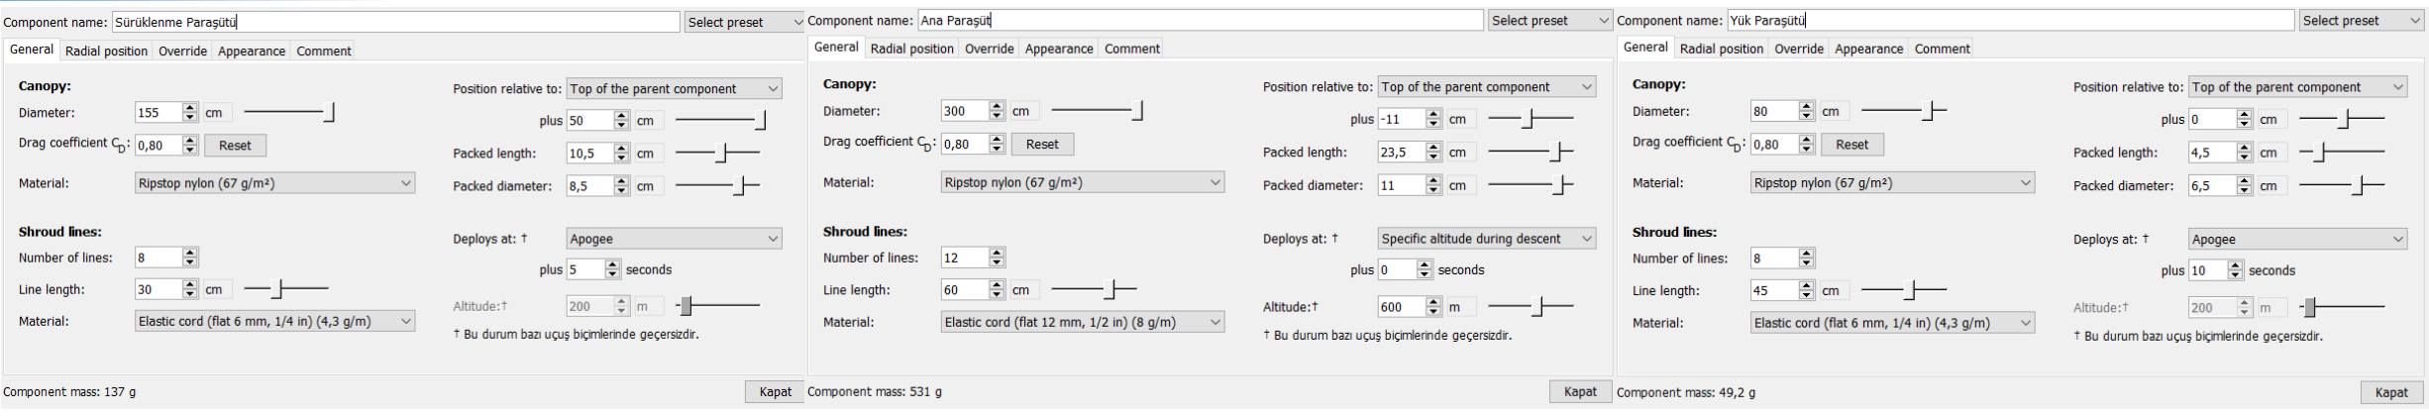
[picture p89: figure]

24 Mart 2021 Çarşamba | 33 2021 TEKNOFEST ROKET YARIŞMASI ÖN TASARIM RAPORU
Sürüklenme Paraşütü | Ana Paraşüt | Yük Paraşütü
- Sürüklenme paraşütü ile ilgili değerler grafikteki gibidir.
- Paraşüt çapı 1550mm, paraşütü tutan ip uzunluğu 300mm ve rokette
105mm uzunluğunda 85mm çapta yer kaplamaktadır.
- Paraşüt ağırlığı 0,137 kg’dır.
- Paraşüt için yırtılmaz kumaş, paraşüt ipi için elastik kordon seçilmiştir.
- Sürüklenme paraşütü rengi yeşil olarak seçilmiştir.
- Faydalı yük paraşütü ile ilgili değerler grafikteki gibidir.
- Paraşüt çapı 800mm, paraşütü tutan ip uzunluğu 450mm ve rokette 45mm uzunluğunda 65mm çapta yer kaplamaktadır.
- Paraşüt ağırlığı 0,0492 kg’dır.
- Paraşüt için yırtılmaz kumaş, paraşüt ipi için elastik kordon seçilmiştir.
- Faydalı yük paraşütü rengi turuncu olarak seçilmiştir.
- Ana paraşütle ile ilgili değerler grafikteki gibidir.
- Paraşüt çapı 3000mm, paraşütü tutan ip uzunluğu 600mm ve rokette 235mm uzunluğunda 110mm çapta yer kaplamaktadır.
- Paraşüt ağırlığı 0,531 kg’dır.
- Paraşüt için yırtılmaz kumaş, paraşüt ipi için elastik kordon seçilmiştir.
- Ana paraşütü rengi kırmızı olarak seçilmiştir.

# Kurtarma Sistemi – Paraşütler - 2

## Takım

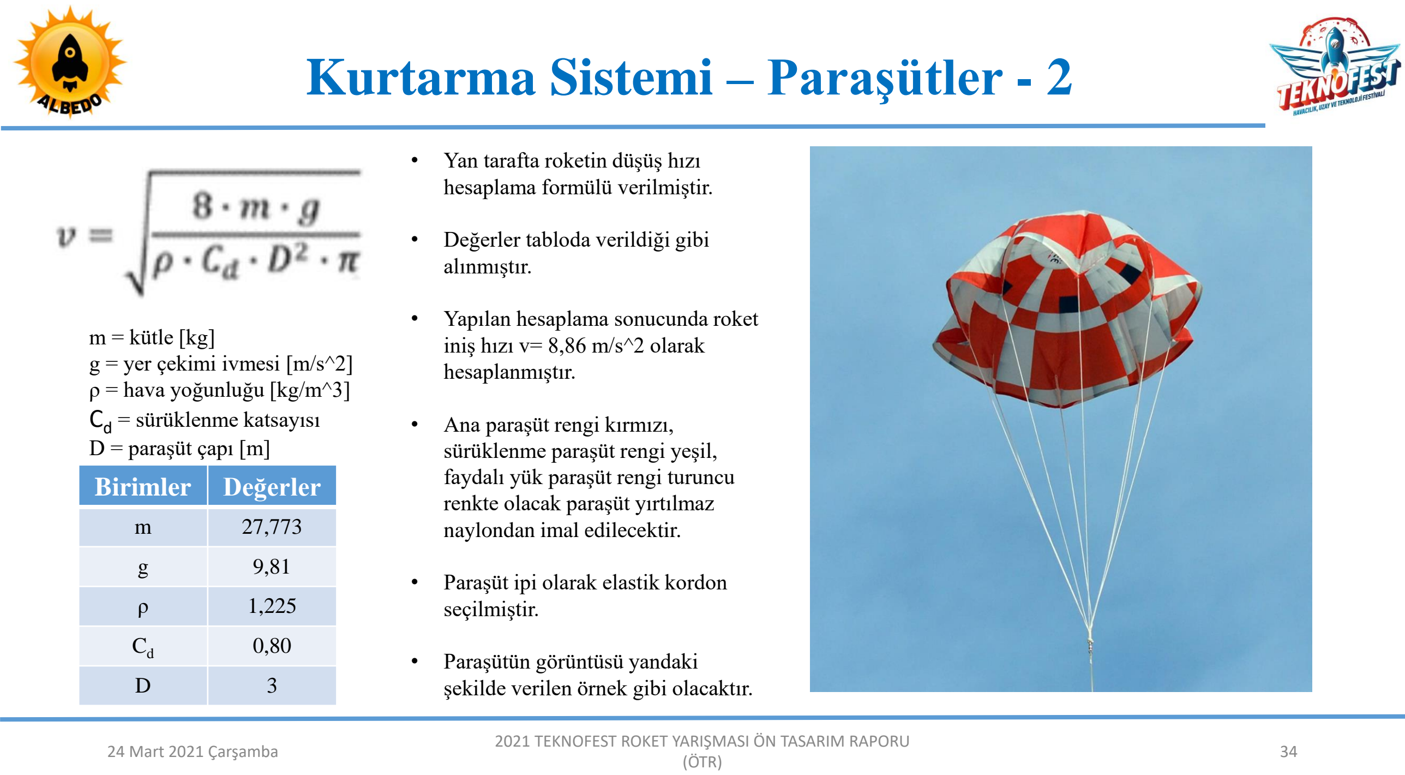
[picture p90: page 34]

## Logosu

24 Mart 2021 Çarşamba | 34 2021 TEKNOFEST ROKET YARIŞMASI ÖN TASARIM RAPORU

m = kütle [kg]
g = yer çekimi ivmesi [m/s^2] ρ = hava yoğunluğu [kg/m^3]
Cd
= sürüklenme katsayısı
D = paraşüt çapı [m]
Birimler | Değerler
m | 27,773
g | 9,81
ρ | 1,225
Cd | 0,80
D | 3
- Yan tarafta roketin düşüş hızı hesaplama formülü verilmiştir.
- Değerler tabloda verildiği gibi alınmıştır.
- Yapılan hesaplama sonucunda roket iniş hızı v= 8,86 m/s^2 olarak hesaplanmıştır.
- Ana paraşüt rengi kırmızı, sürüklenme paraşüt rengi yeşil, faydalı yük paraşüt rengi turuncu renkte olacak paraşüt yırtılmaz naylondan imal edilecektir.
- Paraşüt ipi olarak elastik kordon seçilmiştir.
- Paraşütün görüntüsü yandaki şekilde verilen örnek gibi olacaktır.

# Kurtarma Sistemi – Paraşütler - 3

## Takım Logosu

24 Mart 2021 Çarşamba | 35 2021 TEKNOFEST ROKET YARIŞMASI ÖN TASARIM RAPORU
MPU6050 NEO-6M GPS | BMP 280 | XBee Pro S2C

Ana Bilgisayar

MPU6050

Yedek Bilgisayar

NEO-6M GPS | XBee Pro S2C | MPU6050

Faydalı Yük Bilgisayarı

Roket | Faydalı Yük
- MPU6050: Roketin paraşütünün açılmasında hem ana bilgisayarda hem de yedek bilgisayarda bu sensörden gelen veriler kullanılacaktır.
- NEO 6M GPS: Roketin konumunun tespitinde kullanılacaktır.
- BMP 280 : Roketin irtifa verisinin alınmasında ve roketin paraşüt açma sistemlerinin aktivasyonunda bu sensörün verileri kullanılacak.
- Xbee Pro S2C : Roketin iletişim modülüdür roketin yer üssüyle iletişimini sağlar.
- NEO 6M GPS: Faydalı yükün konumunun tespitinde kullanılacaktır.
- Xbee Pro S2C : Faydalı yükün iletişim modülüdür roketin yer üssüyle iletişimini sağlar.
- MPU6050: Faydalı yükün paraşütünün açılmasında hem ana bilgisayarda hem de yedek bilgisayarda bu sensörden gelen veriler kullanılacaktır.

# Aviyonik Mekanik Görünüm Takım

## Logosu

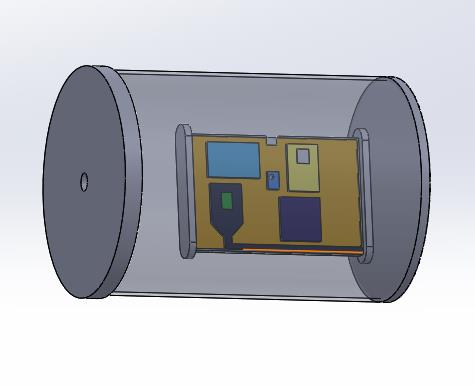
[picture p91: figure]

24 Mart 2021 Çarşamba | 36 2021 TEKNOFEST ROKET YARIŞMASI ÖN TASARIM RAPORU

# Aviyonik – Detay – 1.1 Takım

## Logosu

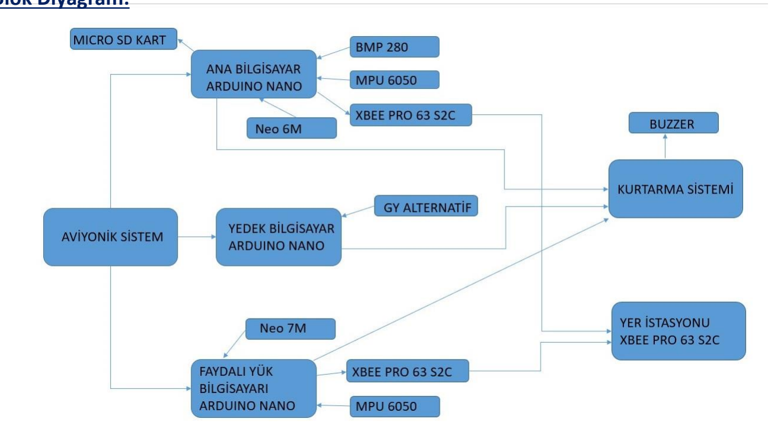
[picture p92: figure]

24 Mart 2021 Çarşamba | 37 2021 TEKNOFEST ROKET YARIŞMASI ÖN TASARIM RAPORU

## Algoritma & Sistem Blok Diyagram:

# Aviyonik – Detay – 1.2 Takım

## Logosu

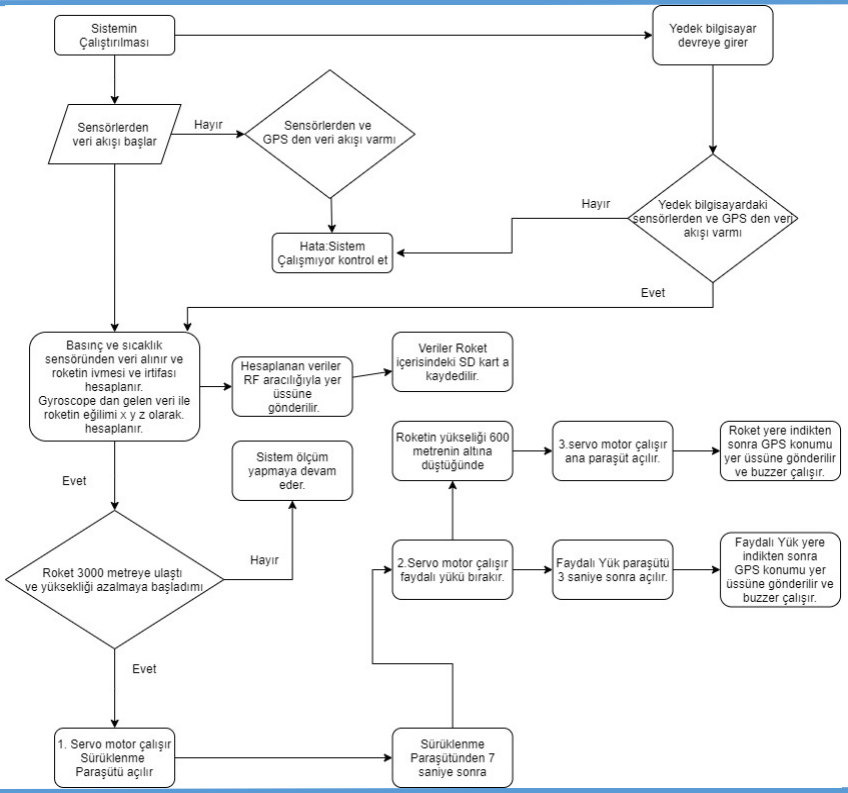
[picture p93: figure]

24 Mart 2021 Çarşamba | 38 2021 TEKNOFEST ROKET YARIŞMASI ÖN TASARIM RAPORU
- Sistemdeki yedek bilgisayar ve ana bilgisayar birbirinden bağımsız çalışacak.
- Yedek bilgisayar ana bilgisayardan birkaç saniye gecikmeyle çalışacak.
- Faydalı yük roketten ayrı düşeceği için kendi içinde bağımsız olarak çalışacaktır.
- Sistemde ve ölçümlerde oluşacak parazitler Kalman Filtresi ile filtrelenecektir. Kalman Filtresi ihtiyaçları karşılamadı taktirde alternatif yollara başvurulacaktır.

## Takım Logosu

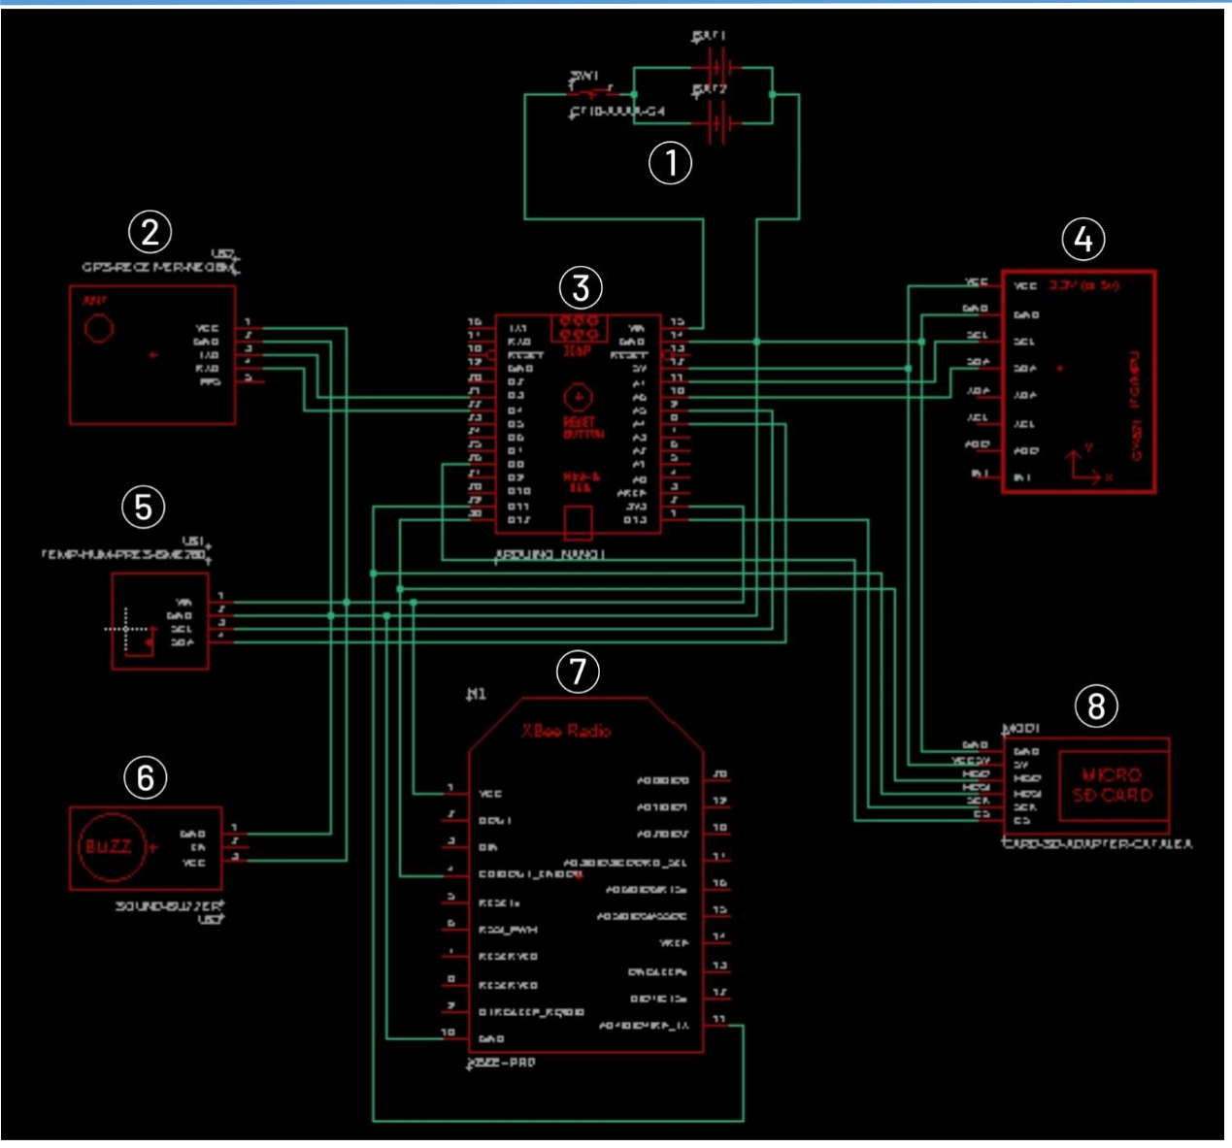
[picture p94: figure]

24 Mart 2021 Çarşamba | 39 2021 TEKNOFEST ROKET YARIŞMASI ÖN TASARIM RAPORU

# Aviyonik – Detay - 2.1

1. 9V Endüstriyel Alkalin Pil : Sistemin ihtiyaçlarına göre değiştirilebilir optimum ihtiyaçlara cevap vermesi için 9V endüstriyel alkalin pil tercih edilmiştir.
2. NEO6MV2 GPS Modülü : Roketin iniş alanının tespiti için kullanılacaktır. Tercih edilme nedeni ardunio nano ile uyumlu çalışması, uygun fiyatlı olmasıdır. İhtiyaca binaen değiştirilebilir.
3. Ardunio Nano: Küçük boyutu, uygun fiyatlı ve kullanım kolaylığından dolayı bu mikrodenetleyici tercih edilmiştir.
4. MPU6050 6 Eksen İvme ve Gyro Sensörü: Roketin ekseninin tespiti için sisteme eklenmiştir. Yedek bilgisayarda bulunacağı gibi ihtiyaca binaen ana bilgisayara da eklenebilir.
5. BMP-280 Basınç Sensörü: Roketimizin irtifasını hesaplamada kullanacağımız sensördür. Tercih edilme nedeni kalitesi ve ardunio’ya uyumluluğudur.
6. Buzzer : Roketin inişten sonra kurtarılmasında kolaylık sağlamak için sisteme eklenmiştir
7. XBee Pro S2C: Sistemin yer üssü ile iletişimi sağlar. Tercih edilme nedeni çok önerilmesi ve sisteme kolay entegre olması.
8. SD Card : Sensörlerden gelen veriyi kaydetmek için sisteme eklenmiştir.

### Ana Uçuş Bilgisayarı :

## Takım Logosu

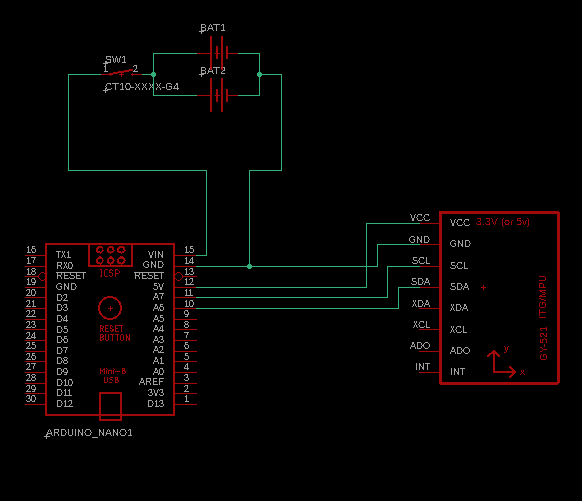
[picture p95: figure]

24 Mart 2021 Çarşamba | 40 2021 TEKNOFEST ROKET YARIŞMASI ÖN TASARIM RAPORU

# Aviyonik – Detay – 2.2

1. 9V Endüstriyel Alkalin Pil : Sistemin ihtiyaçlarına göre değiştirilebilir optimum ihtiyaçlara cevap vermesi için 9V endüstriyel alkalin pil tercih edilmiştir.
2. Ardunio Nano: Yedek bilgisayarın mikrodenetleyicisidir. Ana bilgisayar ve faydalı yük bilgisayarında da aynı parçanın kullanılmasından ötürü kullanılmıştır.
3. MPU6050 6 Eksen İvme ve Gyro Sensörü: Ana bilgisayarın hata vermesi durumunda sistemi devreye sokmak için kullanılacaktır.

### Yedek Uçuş Bilgisayarı :

NOT: Yedek Bilgisayar ana bilgisayardan bağımsız ve birkaç saniye gecikmeli olarak çalışacaktır ana bilgisayarın hata vermesi ve görevini yerine getirememesi durumunda birkaç saniye içinde ana bilgisayarın görevlerini gerçekleştirecektir.

## Takım Logosu

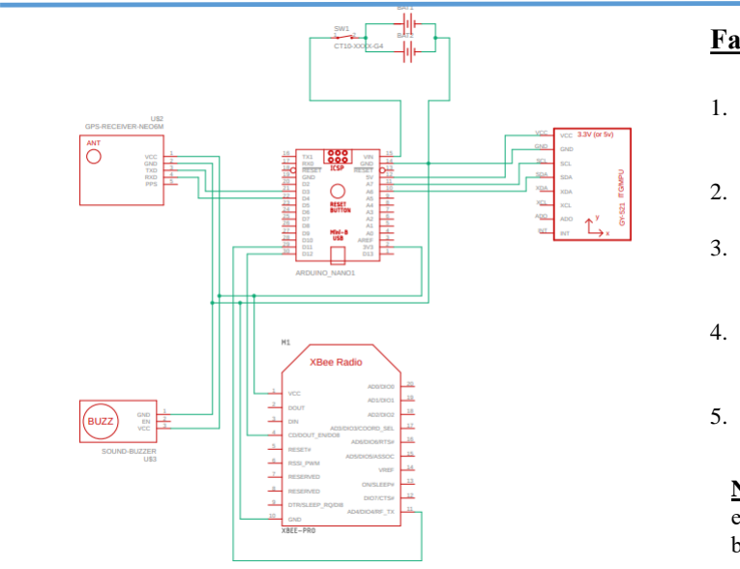
[picture p96: figure]

24 Mart 2021 Çarşamba | 41 2021 TEKNOFEST ROKET YARIŞMASI ÖN TASARIM RAPORU

# Aviyonik – Detay – 2.3

1. 9V Endüstriyel Alkalin Pil : Faydalı yük sisteminin ihtiyaçlarına göre değiştirilebilir optimum ihtiyaçlara cevap vermesi için 9V endüstriyel alkalin pil tercih edilmiştir.
2. Ardunio Nano: Temini kolay ve sistemin geri kalanı ile uyumlu olduğu için tercih edilmiştir.
3. MPU6050 6 Eksen İvme ve Gyro Sensörü: Faydalı yükün bırakılmasından sonra paraşütünün açılmasında kullanılmak için sisteme eklenmiştir.
4. NEO6MV2 GPS Modülü : Faydalı yükün iniş alanının tespiti için kullanılacaktır. Tercih edilme nedeni ardunio nano ile uyumlu çalışması, uygun fiyatlı olmasıdır ihtiyaca binaen değiştirilebilir.
5. Buzzer: Faydalı yük yere inişini yaptıktan sonra buzzer aktif olacak ve ses ile faydalı yükün konum tespiti yapılacak.

### Faydalı Yük Bilgisayarı :

NOT: Faydalı yük bilgisayarı fırlatmadan hemen önce aktif edilecek. Faydalı yük bırakıldıktan hemen sonra faydalı yük bilgisayarı görevini yerine getirmeye başlayacak.

## Takım Logosu

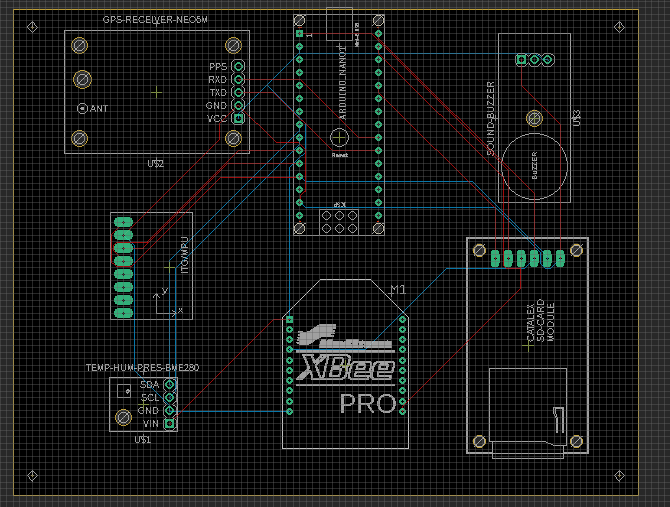
[picture p97: figure]

24 Mart 2021 Çarşamba | 42 2021 TEKNOFEST ROKET YARIŞMASI ÖN TASARIM RAPORU

# Aviyonik – Detay - 2.4

- Modüller ve sensörler üretim aşamasına kadar test yapımında kolaylık olması için baskı devre haline getirilmeyecektir.
- Rokette kullanılacak kartlar baskı devre olarak üretilip toz ve dış ortam etkilerinden muhafaza olacak şekilde paketlenecektir. ( Sensörler ve buzzer hariç )
- Kartlar ve sensörler KTR teslim sürecinde eldeki imkanlar dahilinde soğuk, sıcak, kapalı ve açık ortamlarda test edilecek ve verilerin değişkenliği not edilerek yazılımsal ve mekanik önlemler alınacaktır.

# Aviyonik – Detay - 3.1 Takım

## Logosu

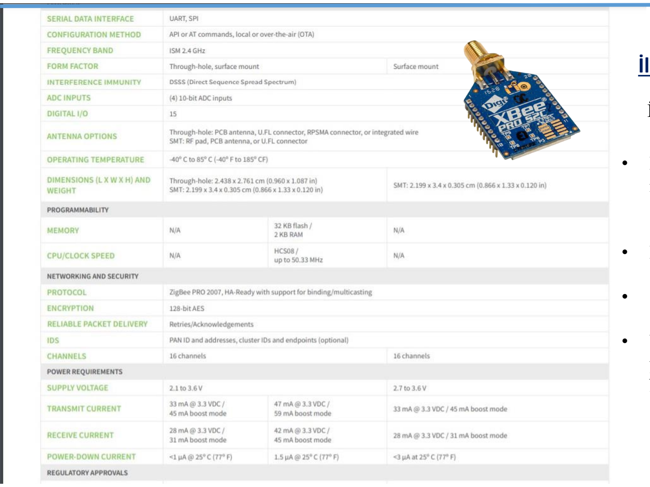
[picture p98: figure]

24 Mart 2021 Çarşamba | 43

## İletişim & Yer İstasyonu:

2021 TEKNOFEST ROKET YARIŞMASI ÖN TASARIM RAPORU

İletişim için tercih edilen modül: xBee Pro S2C

- Modülün dış mekanda menzili 3.2 km anten kullanıldığında bu menzil roketimizin tahmini düşeceği mesafenin üzerinde olacağından modül ihtiyacımızı karşılamaktadır.
- Modül «ISM 2.4 Ghz » hızında veri iletimi sağlamaktadır.
- Sistemde 2.4 Ghz RP-SMA Anten kullanılması planlanmaktadır.
- Yer üssü C# ve C++ dilleri yardımıyla oluşturulacaktır. Oluşturulan yer üssü programında bir hata çıkması ihtimaline karşın Ardunio Nano’nun kendi ara yüzünden de sistemin takibi yapılacak.

# Aviyonik – Detay/3.2 Takım

## Logosu

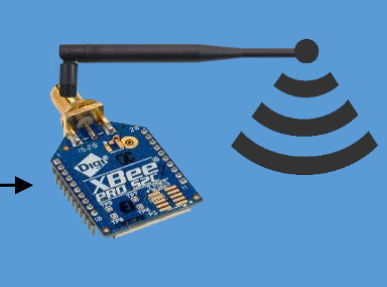
[picture p99: figure]
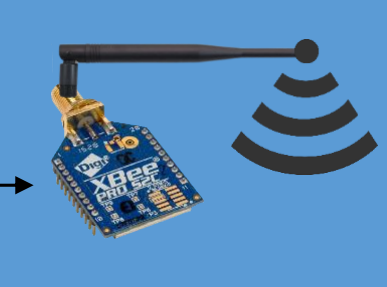
[picture p100: figure]
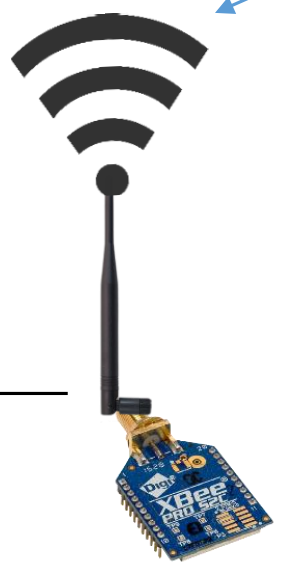
[picture p101: figure]
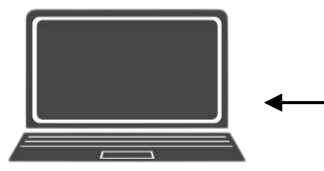
[picture p102: figure]

24 Mart 2021 Çarşamba | 44

## İletişim & Yer İstasyonu:

2021 TEKNOFEST ROKET YARIŞMASI ÖN TASARIM RAPORU

Roket | Faydalı Yük
1. Ardunio Nano’ya bağlı sensörlerden gelen veriler xBee Pro S2C vericisi aracılığı ile yer üssüne 2.4 Ghz hızında aktarılır.
2. Yer üssündeki xBee Pro S2C alıcısı ile roketten gelen veriler alınır ve yer üssü bilgisayarındaki yazılım aracılığıyla yer üssü sorumlusu tarafından görüntülenir.

# Roket Bütünleştirme Stratejisi - 1 Takım

## Logosu

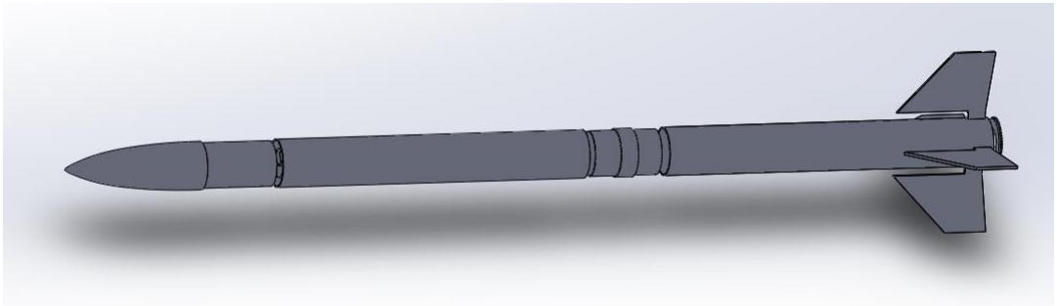
[picture p103: figure]

24 Mart 2021 Çarşamba | 45 2021 TEKNOFEST ROKET YARIŞMASI ÖN TASARIM RAPORU
- Yukarıda tasarlanan roketin montajdan önceki görüntüsü verilmiştir.
- Roketimiz burun konisi, üst gövde, entegrasyon gövdesi ve alt gövdeden oluşmaktadır.
- Burun konisi üst gövdeye sıkı geçme yöntemiyle bağlanacaktır.
- Üst gövde ve alt gövde entegrasyon gövdesi bağlayıcısına sıkıca geçirilerek yuvarlak başlı vida ile sabitlenecektir.
- Entegrasyon bağlayıcısı sıkı geçme yöntemiyle entegrasyon gövdesine montajı yapılacaktır.
- Kanatçıklar yataklarına oturtturularak kaynaklama yöntemi ile montajının yapılması planlanmaktadır.
- Kurtarma sistemi olarak mekanik yaylı sistem kullanılacaktır.

## Takım Logosu

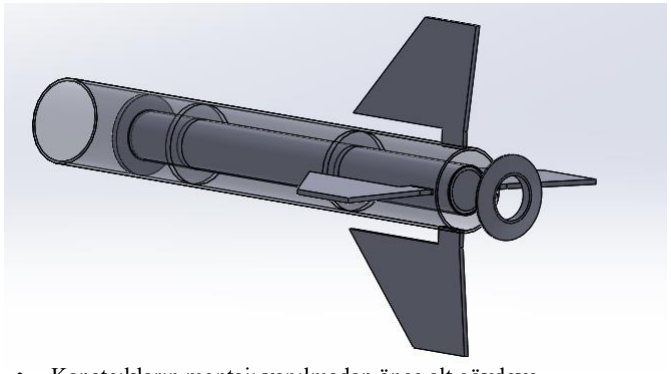
[picture p104: figure]
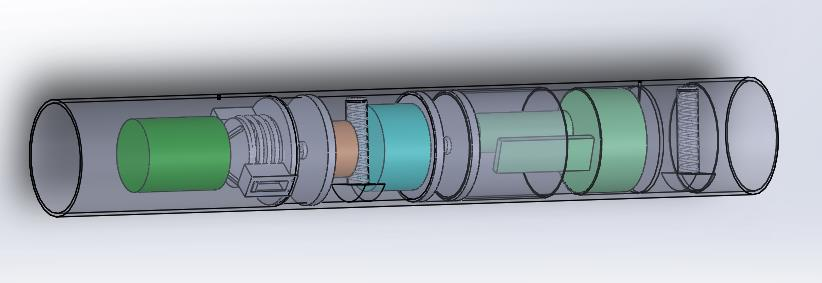
[picture p105: figure]

24 Mart 2021 Çarşamba | 46 2021 TEKNOFEST ROKET YARIŞMASI ÖN TASARIM RAPORU
- Kanatçıkların montajı yapılmadan önce alt gövdeye merkezleme halkalarının montajı yuvarlak başlı vida yardımıyla gövdeye sabitlenir.
- Motor yatağı yerine oturtulur ve motor ön kapağı motor yatağına vidayla sabitlenir.
- Motor, motor yatağına kolayca yerleştirilir.
- Kanatlar gövdedeki kanat için bulunan yuvaya oturtturularak sabitlenir ve kaynak işlemi yapılır.
- Motor kapağı yerine yerleştirilir ve vidalanarak sabitlenir.
- Yukarıda üst gövdenin yerleşim CAD görseli verilmiştir.
- Sistemde kurtarma, aviyonik ve faydalı yük tüpü bulunmaktadır. Bu tüpler sıkı geçme yöntemiyle, tüplere bağlı kapakları yuvarlak başlı vida ile sabitlenecektir.
- Paraşütler şok kordonu yardımıyla mapalara sabitlenecektir.
- Kurtarma sistemi mekanizmaları yuvarlak başlı vida ile sabitlenecek ve hareket etmesinin önüne geçilecektir.
- AltimeterTwo cihazı sprey yapıştırıcı madde yardımıyla, aviyonik tüpün içine montajı yapılır. Aviyonik sistemden çıkacak soketle bağlantısı yapılır.

# Roket Bütünleştirme Stratejisi - 2

# Proje Planı

## Takım Logosu

24 Mart 2021 Çarşamba | 47 2021 TEKNOFEST ROKET YARIŞMASI ÖN TASARIM RAPORU

# Proje Takvimi - 1

## Takım Logosu

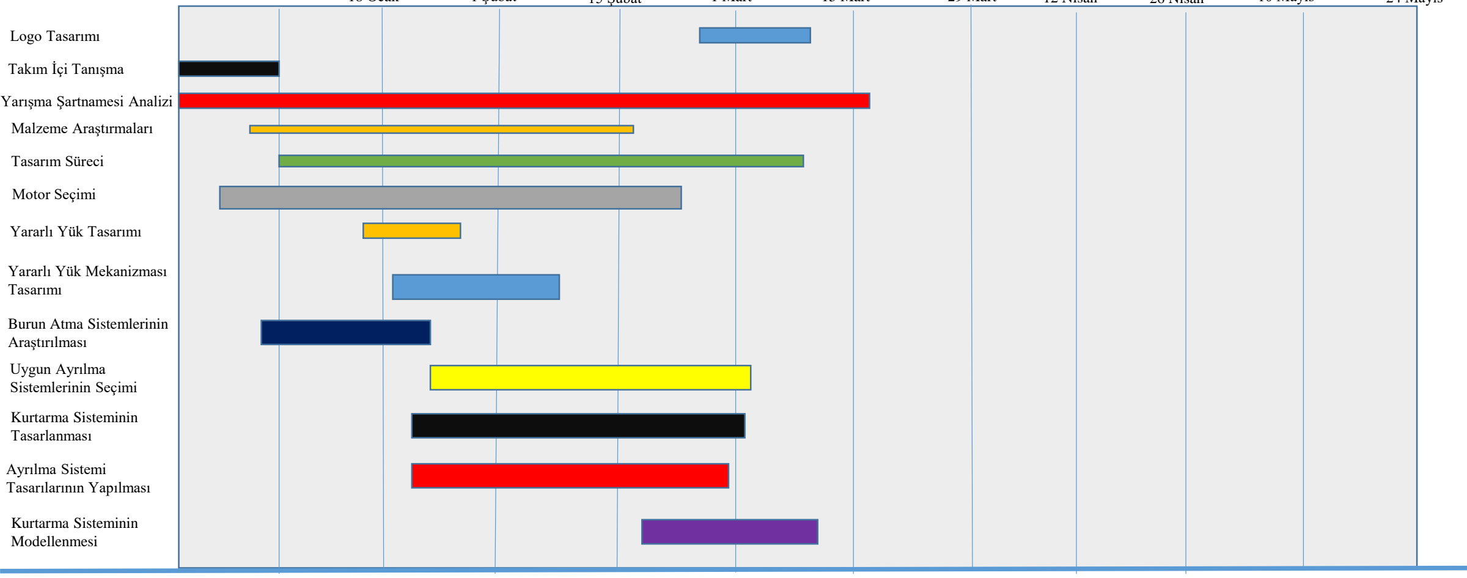
[picture p106: figure]
Logo Tasarımı; Takım İçi Tanışma; Yarışma Şartnamesi Analizi; Malzeme Araştırmaları; Tasarım Süreci; Motor Seçimi; Yararlı Yük Tasarımı; Yararlı Yük Mekanizması Tasarımı; Burun Atma Sistemlerinin Araştırılması; Uygun Ayrılma Sistemlerinin Seçimi; Kurtarma Sisteminin Tasarlanması; Ayrılma Sistemi Tasarılarının Yapılması; Kurtarma Sisteminin Modellenmesi

24 Mart 2021 Çarşamba | 48 2021 TEKNOFEST ROKET YARIŞMASI ÖN TASARIM RAPORU
21 Aralık | 4 Ocak | 18 Ocak | 1 Şubat | 15 Şubat | 1 Mart | 15 Mart | 29 Mart | 12 Nisan | 26 Nisan | 10 Mayıs
24 Mayıs

# Proje Takvimi - 2

## Takım Logosu

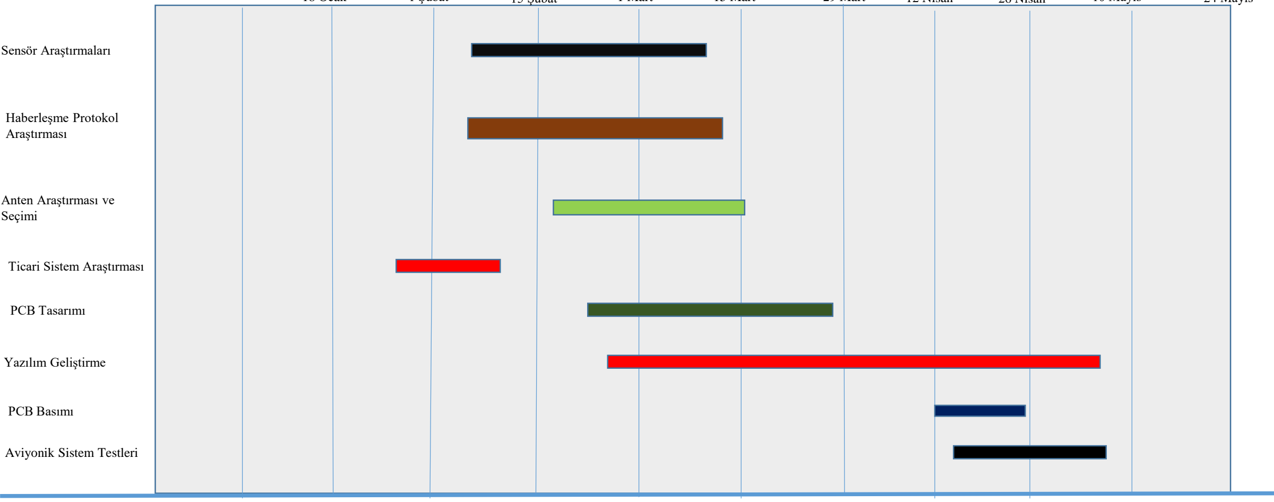
[picture p107: figure]
Sensör Araştırmaları; Haberleşme Protokol Araştırması; Anten Araştırması ve Seçimi; Ticari Sistem Araştırması; PCB Tasarımı; Yazılım Geliştirme; Aviyonik Sistem Testleri; PCB Basımı

24 Mart 2021 Çarşamba | 49 2021 TEKNOFEST ROKET YARIŞMASI ÖN TASARIM RAPORU
21 Aralık | 4 Ocak | 18 Ocak | 1 Şubat | 15 Şubat | 1 Mart | 15 Mart | 29 Mart | 12 Nisan | 26 Nisan | 10 Mayıs | 24 Mayıs

# Proje Takvimi - 3

## Takım Logosu

24 Mart 2021 Çarşamba | 50 2021 TEKNOFEST ROKET YARIŞMASI ÖN TASARIM RAPORU
5 Ocak | 21 Ocak | 6 Şubat | 22 Şubat | 10 Mart | 26 Mart | 11 Nisan | 27 Nisan | 13 Mayıs | 29 Mayıs | 14 Haziran

Aviyonik Sistem Testleri

30 Haziran

Hata Kontrolü ve
Düzeltmeler

Burun Açılma
Mekanizması Üretimi

Yapısal Mukavemet
Analizleri

Dinamik/Kinematik
Analizler

Termal Analizler

Hesaplamalı Akışkanlar
Dinamiği Analizi

Yapısal Mukavemet
Testleri

Kurtarma Sistemleri
Açılma Testleri

Roket Parçalarının İmalatları

Montaj Çalışmaları

# Analizler - 1 Takım

## Logosu

24 Mart 2021 Çarşamba | 51 2021 TEKNOFEST ROKET YARIŞMASI ÖN TASARIM RAPORU

12.04.2021-
19.04.2021

19.04.2021-
26.04.2021

03.05.2021-
10.05.2021

10.05.2021-
17.05.2021

### Yapısal/Mekanik Mukavemet Analizleri

### Dinamik/Kinematik Analizler

### Termal Analizler

### Hesaplamalı Akışkanlar Dinamiği Analizleri

## TARİH ARALIĞI

## ANALİZLER

# Analizler - 2 Takım

## Logosu

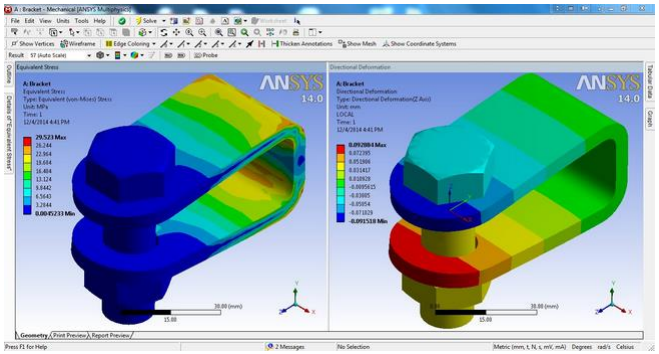
[picture p108: figure]

24 Mart 2021 Çarşamba | 52

### Yapısal/Mekanik Mukavemet Analizleri

- Analizler ANSYS veya
SOLIDWORKS isimli program ile yapılacaktır.
- Sonlu elemanlar yöntemi
kullanılacaktır.
- Statik analiz yapılır.
- Elde edilen ANSYS statik
analiz yorumlama sonuçlarından gerilmeler, deformasyonlar, yorulma ömrü, gerinim değerleri raporlanır.
- Sonrasında hasar kritik değerlerine göre araçta değişikliğe gidilir.

2021 TEKNOFEST ROKET YARIŞMASI ÖN TASARIM RAPORU

# Analizler - 3 Takım

## Logosu

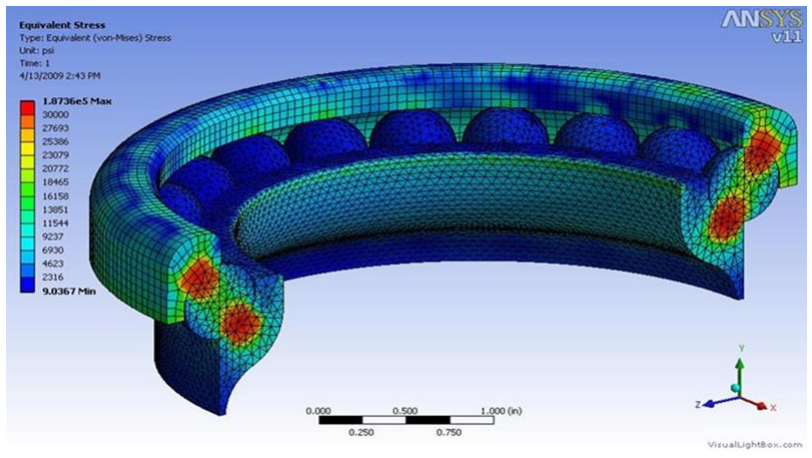
[picture p109: figure]

24 Mart 2021 Çarşamba | 53

Dinamik/Kinematik Analizler

- Modal Analiz : Doğal frekans analizleri ve mod şekilleri için yapılır.
- Harmonik Analiz : Harmonik olarak zamanla değişen yüklere yapının cevabını inceler.
- Transient Dinamik Analiz : Yapının doğrusal veya doğrusal olmayan simülasyonları gösterir.
- Spektrum Analiz : Bir yanıt spektrumu için analiz metodudur.
- Bu analizler doğrultusunda maksimum yer değiştirme ne zaman ve ne olur , harmonik olarak zamanla değişen yükler, transient olarak zamanla değişen yükler ve gerilmeleri ve gerilmeleri hesapları raporlanır.
- Sonrasında standart değerlere göre araçta değişikliğe gidilir.
- Analizler ANSYS veya SOLIDWORKS isimli programlar yardımıyla yapılacaktır.
- Sonlu elemanlar yöntemi kullanılacaktır.

2021 TEKNOFEST ROKET YARIŞMASI ÖN TASARIM RAPORU

# Analizler - 4 Takım

## Logosu

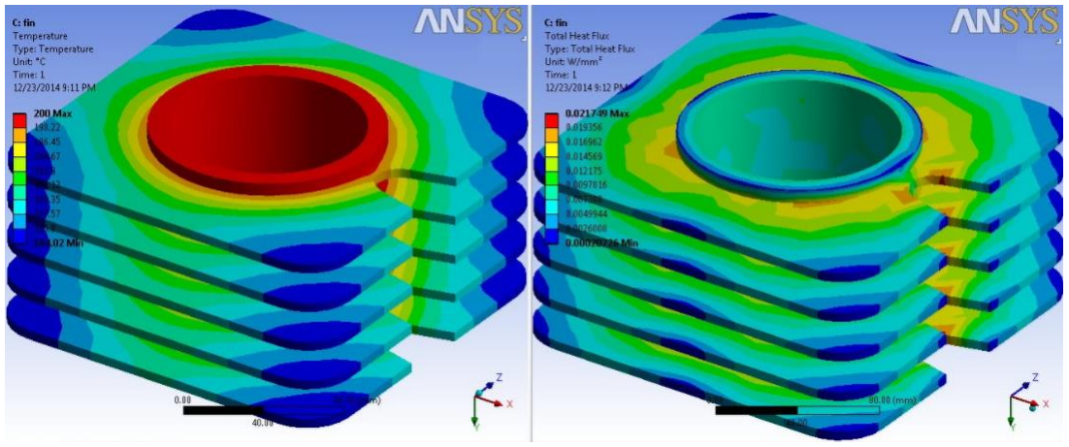
[picture p110: figure]

24 Mart 2021 Çarşamba | 54

Termal Analizler

- Analizler ANSYS veya
SOLIDWORKS isimli
programlarla yapılacaktır.
- Sonlu elemanlar yöntemi ile termal analiz genel olarak karmaşık şekillere sahip
komponent ve montajlarda üç temel ısı transferi olan iletim, taşınım ve ışınım yolu ile olan ısı transferi neticesindeki sıcaklık ve ısı akısı dağılımı bulunur.
- Veriler doğrultusunda araçta modifikasyona başvurulur.

2021 TEKNOFEST ROKET YARIŞMASI ÖN TASARIM RAPORU

# Analizler - 5 Takım

## Logosu

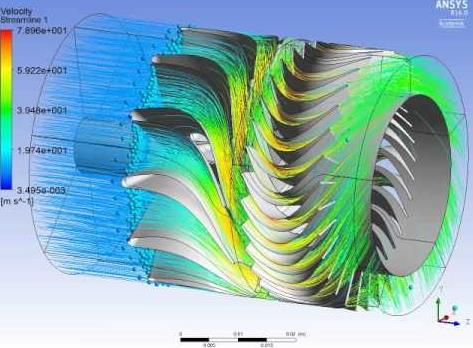
[picture p111: figure]

24 Mart 2021 Çarşamba | 55

Hesaplamalı Akışkanlar Dinamiği Analizleri

- Analizler ANSYS veya SOLIDWORKS isimli programlarla yapılacaktır.
- Burada CFD analiz ile çok fazlı akışlar, newtonian veya newtonian olmayan akışlar, katı-sıvı etkileşim analizleri, ileri türbülans modelleri, dönen parçaların analizleri gibi bir çok uygulamada ANSYS CFD analizleri doğru ve hızlı sonuç elde etmemizi sağlar.
- İlk olarak yapının akışkan hacmi oluşturulur ve model üzerindeki hatalar ve eksiklikler giderilir. Sonrasında yapı sonlu elemanlara ayrılır ve sınır şartları ve kontak yüzeyleri belirlendikten sonra zamana bağlı veya steady-state çözüm alınarak sonuçlar incelenir ve raporlanır.
- Sonrasında verilere göre araçta modifikasyon yapılır.

2021 TEKNOFEST ROKET YARIŞMASI ÖN TASARIM RAPORU

# Testler - 1 Takım

## Logosu

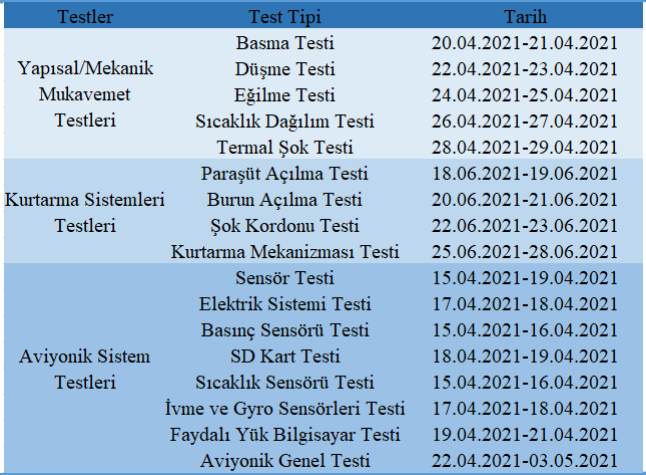
[picture p112: figure]

24 Mart 2021 Çarşamba | 56 2021 TEKNOFEST ROKET YARIŞMASI ÖN TASARIM RAPORU

# Testler - 2 Takım

## Logosu

24 Mart 2021 Çarşamba | 57 2021 TEKNOFEST ROKET YARIŞMASI ÖN TASARIM RAPORU

Basma Testi
- Yapılan basma testinden alınacak verilerle malzemenin akma
mukavemeti, basma kuvveti, elastisite modülü, % birim şekil değişimi, % kesit değişimi gibi veriler elde edilecektir.
- Basma deneyi de universal cihazlarında yapılır ve iki basma kafası arasına yerleştirilen numuneye sabit hızla artan bir basma yükü uygulanır.
- Basma testi numunesine uygulanan kuvvet sonucu, numunedeki % şekil değişikliği gibi elde edilecek verilerin gerçekçiliğine göre üretimi yapılır.

### Yapısal/Mekanik Mukavemet Testleri

- Yapısal/Mekanik mukavemet testi kapsamında basma deneyi, çekme deneyi, düşme deneyleri yapılacaktır.
- Roket gövdesinin üretiminde kullanılacak olan fiberglass ve karbonfiber, alt sistemlerin üretiminde kullanılacak olan alüminyum malzemelerin mukavemet testleri laboratuvar ortamında test edilecektir.

Eğilme Testi
- Eğilme gerilmesi hesabı, eğilme mukavemeti hesabı, akma mukavemeti, maksimum şekil değiştirme, elastisite modülü gibi veriler elde edilir.
- İki desteğe serbest olarak oturtulan, genellikle daire veya dikdörtgen kesitli düz bir deney parçasının yön değiştirmeksizin ortasına bir kuvvet uygulandığında oluşan biçim değiştirmesiyle yapılan bir deneydir.
- Eğilme deneyinde numuneden elde edilecek verilerin gerçekçiliğine göre üretimi yapılır.

Düşme Testi
- Gerçek dünyadaki etkilerin öğeyi nasıl etkileyeceğini simüle edilecek, bir ürünü hükümet, endüstri veya şirket standartlarına uygunluğu açısından değerlendirilecek, etkilenen öğenin performansı hakkında ayrıntılı veriler elde edilecektir.
- Bu test farklı şartlarda, farklı yüksekliklerden numunenin yere bırakılması halinde yapılması planlanmaktadır.
- Düşme testi farklı yüksekliklerden numunenin yere bırakılması şeklinde olacağından yere her seferinde daha hızlı çarpacak ve daha büyük bir kuvvete maruz kalacak bu şekilde malzemenin dayanımı test edilmiş olur ve bu testin gerçekçiliğine göre üretimi yapılır.

# Testler - 3 Takım

## Logosu

24 Mart 2021 Çarşamba | 58 2021 TEKNOFEST ROKET YARIŞMASI ÖN TASARIM RAPORU

### Kurtarma Sistemi Testleri

- Kurtarma sistemi testleri kapsamında paraşüt açılma testi, burun açılma testi, şok kordonu testi, kurtarma mekanizması testi yapılacaktır.
- Kurtarma sistemiyle ilgili olan bu testler laboratuvar / atölye ortamında yapılacaktır.

Paraşüt Açılma Testi
- Hedeflenen test irtifasına
ulaşıldığında paraşütün açılıp
açılmayacağı test edilecektir.
- Sistem tetiklenerek kurtarma sistemindeki paraşütün
istenilen koşullarda açılıp açılmaması denenecektir.
- Testten elde edilen veriler neticesinde rokette tasarlanan paraşütün güvenli olup
olmadığı verisi elde edilmiş olacaktır.
- Paraşüt açılma testinden elde edilecek verilerin
gerçekçiliğine göre sistem düzenlenecektir.

Burun Açılma Testi
- Sinyal geldiğinde burun konisinin yerinden çıkıp çıkmadığı test edilecektir.
- Test edilen yerde burun konisi için sinyal gönderilecek ve çalışıp çalışmadığı görülmüş olacaktır.
- Yapılan test sonrasında sistemin çalışıp çalışmadığı bu doğrultuda roket uçuşunda sorun çıkıp çıkmayacağı ile ilgili veri elde edilmiş olacaktır.
- Bu veriler roketin uçuş esnasında kullanılacağından gerçekçi olması gerekir. Verilerin gerçekçiliğine göre sistem düzenlenecektir.

Şok Kordonu Testi
- Bu test bir bakıma çekme deneyidir. Farkı bir anlık yüksek kuvvet uygulanmasıdır.
- Bu testle birlikte şok kordonunun maruz kaldığı kuvvet sonrasında şok kordonunun dayanıp
dayanmadığı test edilecektir.
- Şok kordonunun dayanıklılığı hakkında veriler elde edilecektir.
- Bu veriler neticesinde şok kordonun roketin uçuş esnasında herhangi bir sorun çıkması engellenmiş olacaktır.
- Yapılan şok kordonu testinin gerçekçiliği neticesinde sistem düzenlenecektir.

Kurtarma Mekanizması
- Buzzer’ın çıkarttığı ses düzeyi açık ortamda test
edilecek ve yeterli olup
olmadığı gözlemlenecektir.
- Yay mekanizmasının sistem içerisinde yeterli olup
olmadığını ve çalışıp
çalışmadığını test etmek
amacıyla yapılacaktır.
- Bu testle mekanizmanın
sistem için yeterli olup
olmadığı ve uçuş esnasında herhangi bir sorun oluşturup oluşturmayacağı
gözlemlenmiş olacaktır.

# Testler - 4 Takım

## Logosu

24 Mart 2021 Çarşamba | 59 2021 TEKNOFEST ROKET YARIŞMASI ÖN TASARIM RAPORU

### Aviyonik Sistem Testleri :

Algoritma Testleri :

- Basınç sensörü ve ivme sensöründen gelen veriler ilgili algoritmasından geçirilerek irtifa ve ivme değerleri elde edilir. Elde edilen bu değer kapalı-açık ortamlarda sıcaklık değiştirilerek değişimler not edilir ve analiz yapılır. Yapılan analizler sonucu elde edilen değerlerin gerçekçiliğine göre algoritmalar düzenlenir.
- Aynı testler yedek bilgisayar ve faydalı yük bilgisayarı içinde tekrarlanır ve verilerin tutarlılığı göz önünde bulundurularak algoritmalar düzenlenir.

Kart Fonksiyonellik Testleri :

- Aviyonik sistemde kullanılan iletişim modülü, GPS modülü gibi modüllerin üst sistemleri menzilleri ve hassasiyet değerleri ölçülecek bu testlere göre modüller yetersizse modüller değiştirilecektir. Sistemlerde kullanılan pillerin ihtiyacı karşılayıp karşılamadığı da test edilecektir.
- Roketin gövde tasarımında kullanılan malzeme ve açılan deliklerin kullanılan sensörler ve iletişim modülünün işlevine uygun çalışmasına engel olup olmadığı test edilecektir. Bu test roket gövdesinin ve diğer unsurların yapıldığı malzemelerden kapalı kutular yapılarak aviyonik sistem bu kutuların içinde denenecektir.
- Elde edilen sonuçlara göre roket malzemelerinde değişikliğe gidilecektir.

İletişim Testleri :

- Sistemde kullanılan iletişim modülünün menzili yatay
düzlemde ve dikey düzlemde sinyal gücü ölçülerek
yapılacaktır.
- İletişim modülü üzerinde bağlantı testi, text sending testi, sensör verisi gönderme testi, paket iletim testi gibi testler yapılacaktır.
- Elde edilen veriler ile modülün verimliliği ve ihtiyacı karşılayıp karşılamaması durumuna göre modül değişikliği yapılacaktır.

# Testler - 5 Takım

## Logosu

24 Mart 2021 Çarşamba | 60 2021 TEKNOFEST ROKET YARIŞMASI ÖN TASARIM RAPORU

### Aviyonik Sistem Testleri :

Elektronik Sistem Testi:
Sistemdeki modüller ve sensörler algoritma testinden geçirildikten sonra sistem birleştirilip sistemin güç kaynağının yeterli olup olmadığı test edilecektir. Bu test de kriter bataryanın sistemi çalıştırmaya yetip yetmemesi ve sistemin ihtiyaç duyulan süreden fazla olacak şekilde faal bir şekilde çalışıp çalışmayacağıdır.

Basınç ve İvme Sensörü Testi:
Basınç ve ivme sensörü roketin içerisinde düzgün çalışıp çalışmadığı ve istenilen kriterleri karşılayıp karşılamadığı test edilecektir.

SD Kart Testi:
Sensörlerden gelen veriler SD karta kaydedilecektir. Bu test de verilerin SD karta kaydolup olmadığı test edilecektir.

Sıcaklık Sensörü Testi:
Bu test de sıcaklık sensörünün kapalı ortamda gerçekçi ölçümler yapıp yapmadığı termometre kullanılarak test edilecektir.

Faydalı Yük Bilgisayarı Testi:
Faydalı yük bilgisayarının işlevini yerine getirip getirmediği ve faydalı yük bilgisayarında bulunan modüllerin, bataryanın ve iletişim modülünün yeterliliği test edilecektir.

Aviyonik Genel Testi:
Bu test en son yapılacaktır. Sistemin tamamı birleştirilerek herhangi bir aksaklık çıkmadan istenilen verimde çalışıp çalışmadığı test edilecektir. Eğer bu testten de olumlu sonuç alınırsa devreler baskı devre haline getirilip dış etkenlerden korucu jelatin paketlere konularak rokete entegre etmeye hazır duruma getirilecektir.

## Bütçe 1 Takım Logosu

24 Mart 2021 Çarşamba | 61 2021 TEKNOFEST ROKET YARIŞMASI ÖN TASARIM RAPORU
Ürün | Malzeme | Alan (m2) | Adet | Fiyat (₺)
Mapa | Dövülmüş Çelik | - | 3 | 67,5
Paraşüt Kumaşı | Yırtılmaz Naylon | 10 | 1 | 300
Paraşüt İpi (6mm) | Elastik Kordon | 5 metre | 1 | 15
Paraşüt İpi (12mm) | Elastik Kordon | 10 metre | 1 | 60
Üst Gövde + Alt Gövde | Fiberglass | 4 | 1 | 623,88
Entegrasyon Gövdesi | Karbonfiber | 0,3 | 1 | 65
Yapıştırıcı | Epoksi (250g) | - | 1 | 120
Burun Konisi | Fiberglass | 0,3 | 1 | 71,4
Faydalı Yük | Paslanmaz Çelik | - | 1 | 160
Şok Kordonu | Elastik Kordon | 10 metre | 4 | 110
Motor Yatağı | Alüminyum | 0,4 | 1 | 84,5
Kanatçık | Alüminyum | 0,5 | 4 | 224,24
Mekanizma Tüpü + E. G. Bağlayıcısı | Alüminyum | 0,300 | 1+1 | 42,5
Aviyonik ve Yük Tüpü | Fiberglass | 0,760 | 1+1 | 140,6
Kapak + Merkezleme Halkası | Fiberglass | - | 3+2 | 25
Kapak | Alüminyum | - | 4 | 60

# Bütçe - 2 Takım

## Logosu

24 Mart 2021 Çarşamba | 62 2021 TEKNOFEST ROKET YARIŞMASI ÖN TASARIM RAPORU
Ürün | Adet | Fiyat
Ardunio Nano | 3 | 394,74
Micro SD kart ve modülü | 1+1 | 57,71
NEO-6M GPS Modülü | 2 | 260,2
BMP 280 | 1 | 10,46
MPU 6050 | 3 | 24,72
xBee Pro S2C | 2 | 898,76
Duracell 9V Alkalin 9V Pil | 4 | 72
Epoksi (Duratek DTE 1200 ve Sertleştirici (Duratek DTS 1151) | 1 | 320
Servo Motor | 4 | 602,72
Kablo | 1 rulo | 40
Yay | 3 | 300
Servo Motor Kablosu (JST) | 10m | 80
Toplam | | 5,230.93

# Risk Analizi Takım

## Logosu

24 Mart 2021 Çarşamba | 63 2021 TEKNOFEST ROKET YARIŞMASI ÖN TASARIM RAPORU
Risk | Önlem
Aviyonik sistem arızasının oluşması | Aviyonik sistem arızasının oluşması durumunda yedek aviyonik sistemi bulunmaktadır.
Ana bilgisayarın batarya bağlantısında sorun oluşması | Yedek batarya yardımıyla ana bilgisayarda herhangi bir güç eksiğinin önüne geçilmiştir.
Basınç sensörünün çalışmaması | Basınç sensörünün çalışmaması durumunda sistem ivme sensörü yardımıyla aktif hale getirilecektir.
Aviyonik sistemin ortam etkilerinden zarar görmesi | Aviyonik sistemin ortam etkilerinden zarar görmesini engellemek amacıyla devreler jelatin paketler halinde paketlenecektir.

# Kontrol Listesi - 1 Takım

## Logosu

24 Mart 2021 Çarşamba | 64 2021 TEKNOFEST ROKET YARIŞMASI ÖN TASARIM RAPORU
NO | Gereksinim Madde No. | Gereksinim | Karşılama Durumu | ÖTR Slayt No | Açıklama
1 | 3.1.11. | Takımlar en az dört (4) en fazla altı (6) kişiden oluşmalıdır. | | 2
2 | 3.1.13. | Her takımın yarışmaya bir (1) danışmanla katılması zorunludur. Takım danışmanı ile ilgili özellikler 3.1.26 no’lu maddede yer almaktadır. | | 2 | 3.1.26 no’lu maddede yer alan Takım danışmanı ile ilgili özellikler ilgili kriterlere uygundur.
3 | 3.1.21. | Takımlar; Proje Planı, Proje Bütçesi, Kontrol Listesi, Görevli Personel Listesi (Takım Danışmanı dâhil olacak şekilde) hazırlamalıdır. | | 2, 47-61 | Mevcut durum için proje bütçesi hazırlanmış olup sponsor bilgileri KTR raporunda kesinleşecek ve belirtilecektir.
4 | 3.2.1.18. | Takımlar faydalı yüklerini “Unspecified Mass” ismiyle giremezler. Faydalı yük “PAYLOAD” ismi ile adlandırılıp, kütlesi en az 4000 gram olarak girilecektir. Şekil 1 ile verilen “Fırlatma Simülasyonu Launch Simulation” ekranında yer alan değerler simülasyona girilmelidir. Bu değerler ile benzetim yapmamış olan takımlar elenecektir. | | 10, 19, 20
5 | 3.2.1.19. | Lise kategorisindeki takımlar hariç tüm takımlar üç (3) serbestlik dereceli uçuş benzetim ve modellemesini kendileri yapacak şekilde bir kod (açık kaynak kodları kullanılarak) geliştirecek ve ilgili tasarım raporlarında bu kod ve kodun çıktılarını (Tasarım Raporları şablonlarında hangi çıktıların isteneceği takımlara iletilecektir) TEKNOFEST Roket Yarışması Komitesine sunulacaktır. | | 9 | Kod akış şeması 9 numaralı slayt da verilmiştir. Kod detayları KTR raporunda sunulacaktır.
6 | 3.2.2. | KURTARMA SİSTEMİ GEREKSİNİMLERİ | | 28-35 | 3.2.2 ile ilgili maddelerin gereksinimleri 28-35 arası numaralı slayt da mevcuttur

# Kontrol Listesi - 2 Takım

## Logosu

24 Mart 2021 Çarşamba | 65 2021 TEKNOFEST ROKET YARIŞMASI ÖN TASARIM RAPORU
NO | Gereksinim Madde No. | Gereksinim | Karşılama Durumu | ÖTR Slayt No | Açıklama
7 | 3.2.3 | Faydalı Yük Gereksinimleri | | 19-20 | 3.2.3 ile ilgili maddelerin tamamı 19-20 numaralı slayt da belirtilmiştir.
8 | 3.2.4.3. | Roketin tüm parçalarının azamî dış çapları aynı değerde olmalıdır (Kademelerin farklı çaplara sahip olması ve kademeler arasında çap değişimine izin verilmemektedir). | | 5 | Open Rocket Programındaki çizim üzerinde ölçülendirilerek belirtilmiştir.
9 | 3.2.6.1 | Roket içerisinde biri “ANA” diğeri “YEDEK” olacak şekilde iki (2) adet, birbirinden farklı uçuş bilgisayarı bulunmalıdır. | | 39-40 | .
10 | 4.1.6 | Hata Modları ve Etkileri Analizi ile sonuçları da ÖTR’de sunulacaktır (Takımların Hata Modları ve Etkileri Analizi çalışmalarını yapabilmeleri için şablon dokümanlar internet sitesi üzerinden paylaşılacaktır). | | 64-65
- | Yeşil | Tam karşılanmaktadır
- | Sarı | Kısmen karşılanmaktadır
- | Kırmızı | Karşılanmamaktadır.

Herkese Açık | Public HTEA

# Hata Türleri ve Etkileri Analizi - 1

## Takım Logosu

24 Mart 2021 Çarşamba | 66 2021 TEKNOFEST ROKET YARIŞMASI ÖN TASARIM RAPORU
Öge/Fonksiyon | Fonksiyon Tanımı | Hata Türü | Hata Nedeni | Ömür/ Görev Evresi | Hata Etkisi | Hata Tespit Yöntemi | Mevcut Tasarım Kontrolleri | Alınan Tedbirler | Şiddet Puanı (S)
İncelenen öge ve süreç adımı nedir? | Fonsiyonun gerçekleşmesi için gereken nedir?/ Fonksiyon tanımı nedir? | Tanımlanmış gereksinimin sağlanamama durumu nedir? | Hatanın oluşmasına sebep olan yetersizlikler/olayl ar nelerdir? | Hatanın gözlemlendiği ömür/ görev evresi nedir? | Yerel Etki | Son Etki | Söz konusu görev evresinde hatanın tespiti ne şekilde olmakta? | Önleyici (P) Hata türünü ve/veya hata nedenini engelleyen mevcut kontroller nelerdir? | Tespit Edici (D) Hatanın tespit edilmesini sağlayan mevcut kontroller nelerdir? | Hata oluştuktan sonra hatanın etkisini ortadan kaldıran ya da azaltan tasarım tedbirleri nelerdir? | Görev başarımı ve Değerlendirme Komitesi beklentileri açısından bu etki ne derece önemlidir?
Kablo | Enerjiyi iletmek | Kopması, aşınması | Keskin bir kenar tarafından bir kuvvete maaruz kalması | Taşıma | Enerjiyi iletememesi | Roketin fonksiyonlarının doğru çalışamaması | Görsel muayene | Kabloları daha dikkatli bir şekilde yerleştirmek | Multimetre ile akım kontrolü yapmak | Kablolara özel bir giriş yaparak onları güvenli bir yerden geçirmek | 7
Cıvata | İki parçayı birbirine bağlamak | Cıvatanın paslanması | Yüksek neme maruziyet | Depolama, Taşıma | Cıvatanın mukavemetinin azalması | Roketin yapısal bütünlüğünü yitirmesi | Görsel muayene | Rokette kullanılan cıvataların korozyona dayanıklı malzeme ile kaplanması | Nem testi yapılması | ikinci bir bağlantı elemanının aynı yapısal parçaların bağlantısı için kullanılması | 7
Uçuş Bilgisayarı | Uçuş verilerinin analiz edilmesi ve görev komutlarının oluşturulması | İşlemci arızası | Yüksek titreşim ve şok seviyeleri | Uçuş | UB yazılımının çalıştırılamaması | Görev adımlarının başarılı bir şekilde gerçekleştirilemem esi | Telemetre verileri | Uçuşta beklenen titreşim ve şok seviyelerinde çalışabilecek UB seçimi | Uçuş öncesi yer testleri | Yedek UB kullanımı | 10
Sensörler | Dış dünyadaki verileri ölçüp sanala aktarması | Soket bağlantısının kopması | Yüksek titreşim ve şok seviyeleri | Uçuş | Görevini yerine getirememesi | Kurtarma sisteminin ve istenilen verilerin alınamaması | Görsel muayene, Telemetre verileri | Sensörlerin lehim bağlantıları sağlamlaştırılır | Uçuş öncesi yer testleri | Jelatinle kaplamak | 7

Herkese Açık | Public HTEA

# Hata Türleri ve Etkileri Analizi -2

## Takım Logosu

24 Mart 2021 Çarşamba | 67 2021 TEKNOFEST ROKET YARIŞMASI ÖN TASARIM RAPORU
Hata No | Öge/Fonksiyon | Fonksiyon Tanımı | Hata Türü | Hata Nedeni | Ömür/ Görev Evresi | Hata Etkisi | Hata Tespit Yöntemi | Mevcut Tasarım Kontrolleri | Alınan Tedbirler | Şiddet Puanı (S)
Hata No | İncelenen öge ve süreç adımı nedir? | Fonksiyonun gerçekleşmesi için gereken nedir?/ Fonksiyon tanımı nedir? | Tanımlanmış gereksinimin sağlanamama durumu nedir? | Hatanın oluşmasına sebep olan yetersizlikler/olay lar nelerdir? | Hatanın gözlemlendiği ömür/ görev evresi nedir? | Yerel Etki | Son Etki | Söz konusu görev evresinde hatanın tespiti ne şekilde olmakta? | Önleyici (P) Hata türünü ve/veya hata nedenini engelleyen mevcut kontroller nelerdir? | Tespit Edici (D) Hatanın tespit edilmesini sağlayan mevcut kontroller nelerdir? | Hata oluştuktan sonra hatanın etkisini ortadan kaldıran ya da azaltan tasarım tedbirleri nelerdir? | Görev başarımı ve Değerlendirme Komitesi beklentileri açısından bu etki ne derece önemlidir?
HT 5 | Batarya | Aviyoniklere güç sağlanması | Arayüzde temassızlık sonucu bataryanın güç aktarımı yapamaması | Montaj hatası ve uçuş titreşimi | Uçuş | Rokette bulunan aviyoniklerin çalışmaması | Görev komutlarının üretimememesi ve roket ile iletişim kurulamaması | Aviyonik güç kontrolü ve Telemetre veriler | Kilit mekanizmalı konektör seçimi | Uçuş öncesi yer testleri | Besleme hattı yedeklenmesi | 7
HT 6 | Faydalı yük ayırma mekanizması | Faydalı Yük'ün istenen koşullarda sistemden ayrılması | İstemsiz Faydalı Yük ayrılması | Hatalı sinyal iletim | Uçuş | Faydalı Yük'ün yanlış irtifada sistemden ayrılması | Yanlış irtifada Faydalı Yük ayrılması sonucu kurtarma işleminin başarısız olması | Telemetre verileri | Faydalı Yük ayrılma koşullarının uçuş algoritmasında birkaç defa kontrol edilmesi | Algoritma hata koşullarının yerde test edilmesi | Hatalı ayrılma sonrası Faydalı Yük'ün sistem dışına nominal bir şekilde çıkıp paraşütün açılmasına olanak verecek şekilde yerleştirilmesi | 7
HT 7 | Kurtarma mekanizması | Roketi kurtarmak Sistemin | aviyonik tarafından tetiklenmemesi | Hatalı sinyal iletim, iletim hattında kopukluk, sistem arızası | Uçuş, kurtarma | Sistemin açılmaması | Roket çakılması | Ölçüm muayene, görsel muayene | Yedek aviyonik ile ana aviyonik bilgisayarın birbirinden bağımsız çalışması | Algoritma hata koşullarının yerde test edilmesi | Yedek aviyonik bilgisayarın aktif olması | 10

# Optimizasyona Tabii Gereksinimler Takım

## Logosu

24 Mart 2021 Çarşamba | 68 2021 TEKNOFEST ROKET YARIŞMASI ÖN TASARIM RAPORU
Gereksinim | Tasarım Seçenekleri | Optimizasyon Kriteri - 1 | Optimizasyon Kriteri - 2 | Sonuç ve Tasarıma Etkisi
Gövde Malzemesi Seçimi | Fiberglass/ Karbonfiber Gövde | Kütle (kg) (5,825-5,6109) | Hız (m/s) (265-267) | Yapılan optimizasyon sonucu roketin daha yüksek bir irtifaya çıkması sağlanmış ve hızında armış görülmüştür. Roket stabilitesini sağlamak için bu şekilde yapılmıştır.
Burun Konisi Seçimi | Haack Series/ Parabolic Series | Kütle (kg) (1,238-1,259) | Şekil Parametresi (0,333-1) | Kütlede artış görülmesine rağmen burun konisindeki değişim roket irtifasını arttırmıştır. Roket stabilitesini sağlamak için bu şekilde yapılmıştır.
Kurtarma Mekanizması Tüpünün Malzeme Seçimi | Alüminyum/ Fiberglass | Kütle (kg) (0,417-0,286) | Hız (m/s) (265-266) | Kurtarma mekanizması tüpünün malzemesi değiştirilerek roketin daha yüksek irtifaya çıkması sağlanmış ve hızında artış görülmüştür. Roket stabilitesini sağlamak için bu şekilde yapılmıştır.
