MertHayla/Teknofest-tasarim-raporlari/Teknofest Raporları/Kurtarma sistemi Solidworks çizimleri/Montaj.SLDASM

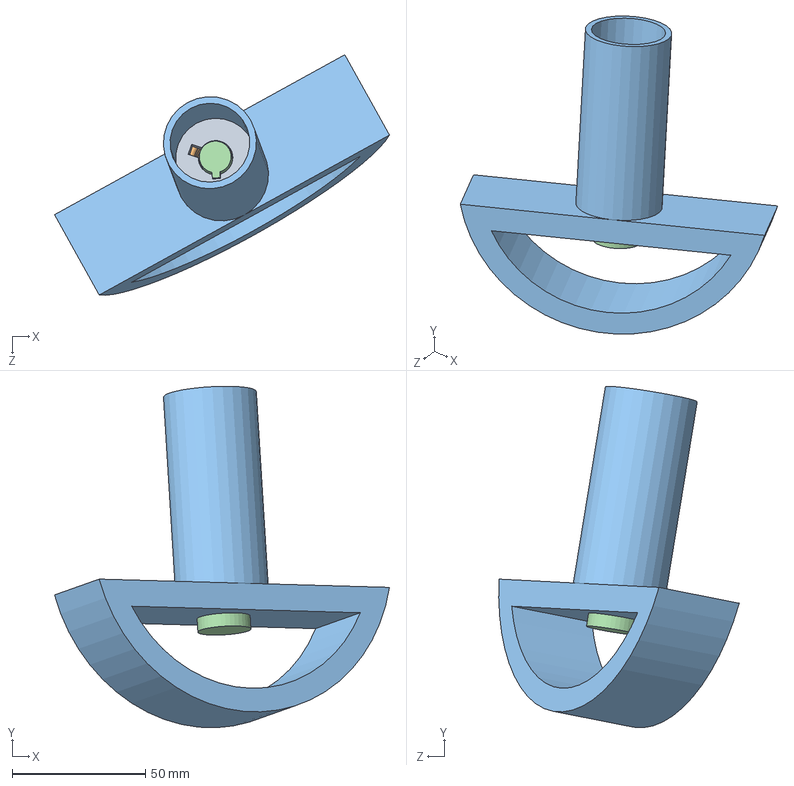
[picture p113: CAD file, 2024-01-19]
Teknofest Raporları/Kurtarma sistemi Solidworks çizimleri/Montaj.SLDASM
125.7 x 128.1 x 90.3 mm
Üst Kapak
FaydalıYükKurtarmaYay
Gövde
Mil
