MertHayla/Teknofest-tasarim-raporlari/Teknofest Raporları/Kurtarma sistemi Solidworks çizimleri/FaydalıYük.AnaParaşütAçılma.SLDASM

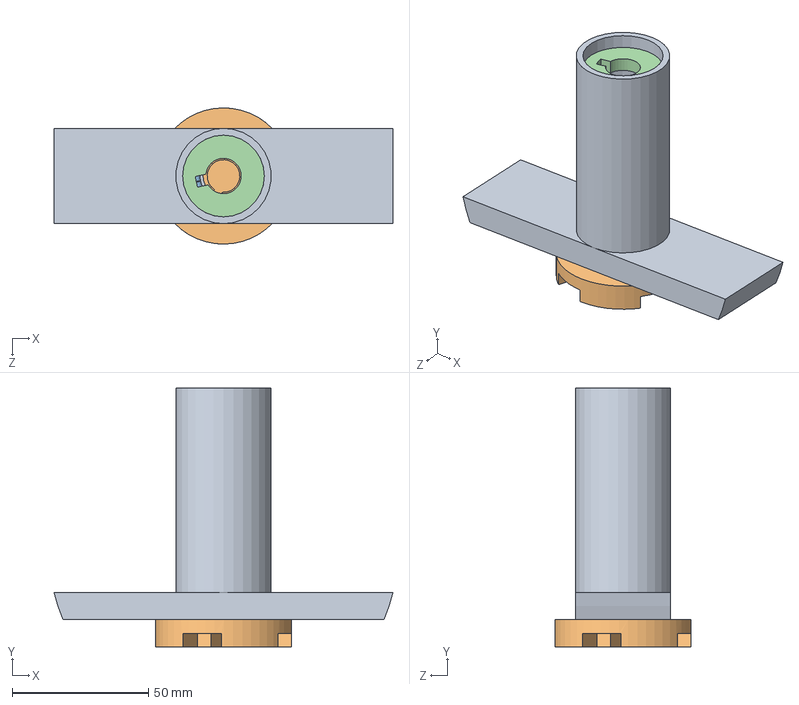
[picture p114: CAD file, 2024-01-19]
Teknofest Raporları/Kurtarma sistemi Solidworks çizimleri/FaydalıYük.AnaParaşütAçılma.SLDASM
124.4 x 95.0 x 50.0 mm
Gövde
Mil
FaydalıYükKurtarmaYay
Üst Kapak
