MertHayla/Teknofest-tasarim-raporlari/Teknofest Raporları/Kurtarma sistemi Solidworks çizimleri/BurunKonisiAçılma.SLDASM

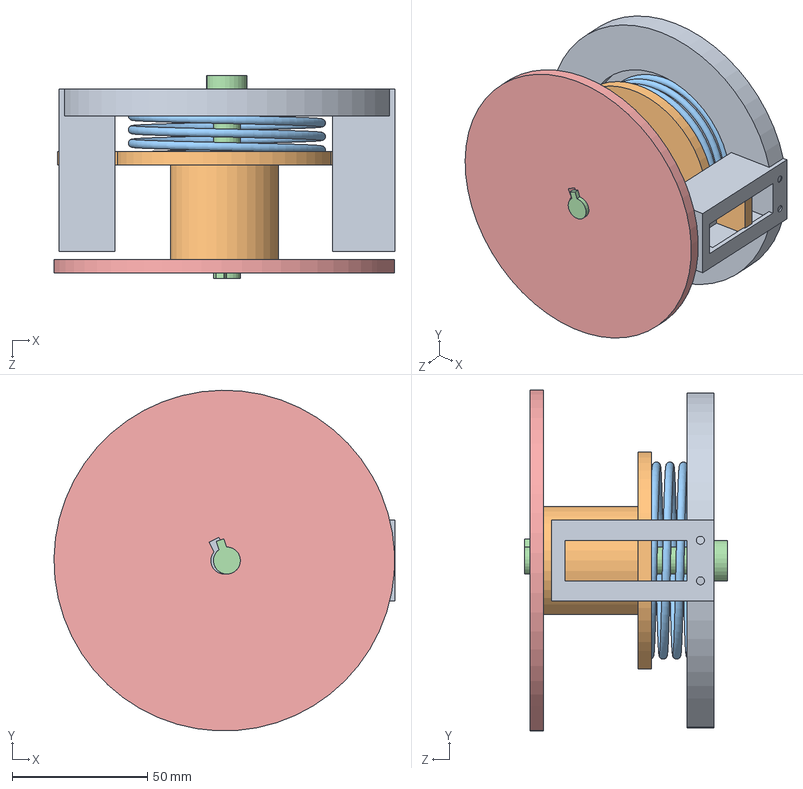
[picture p115: CAD file, 2024-01-19]
Teknofest Raporları/Kurtarma sistemi Solidworks çizimleri/BurunKonisiAçılma.SLDASM
126.1 x 125.9 x 75.0 mm
Kurtarma Gövdesi 1
Kurtarma Gövdesi 2
Açık Yay
Mil
Kurtarma Gövdesi 3
