MertHayla/Teknofest-tasarim-raporlari/Teknofest Raporları/Kurtarma sistemi Solidworks çizimleri/Üst Kapak .SLDPRT

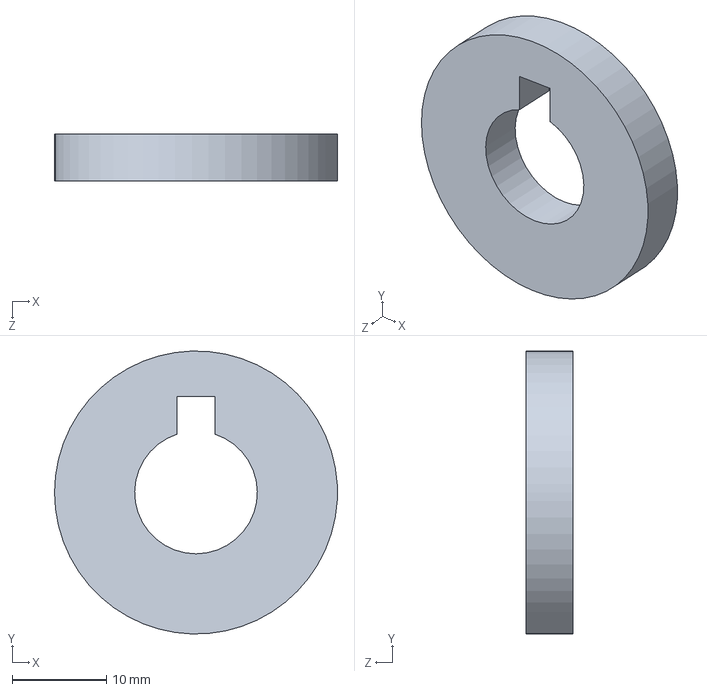
[picture p116: CAD file, 2024-01-19]
Teknofest Raporları/Kurtarma sistemi Solidworks çizimleri/Üst Kapak .SLDPRT
30.0 x 30.0 x 5.00 mm
