MertHayla/Teknofest-tasarim-raporlari/Teknofest Raporları/Kurtarma sistemi Solidworks çizimleri/Mil .SLDPRT

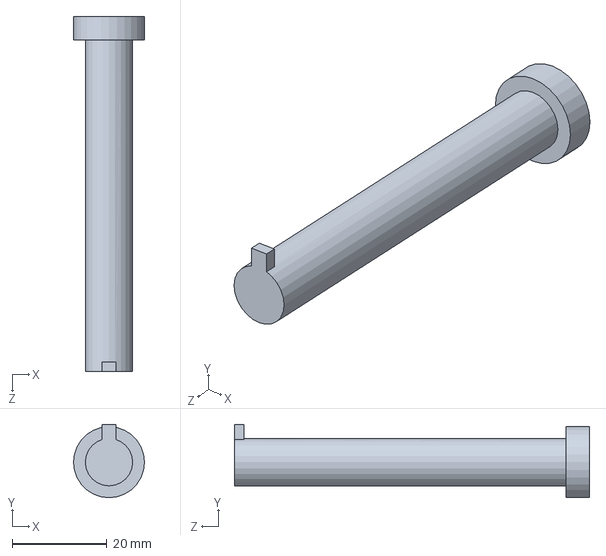
[picture p117: CAD file, 2024-01-19]
Teknofest Raporları/Kurtarma sistemi Solidworks çizimleri/Mil .SLDPRT
15.0 x 15.5 x 75.0 mm
