MertHayla/Teknofest-tasarim-raporlari/Teknofest Raporları/Kurtarma sistemi Solidworks çizimleri/Gövde .SLDPRT

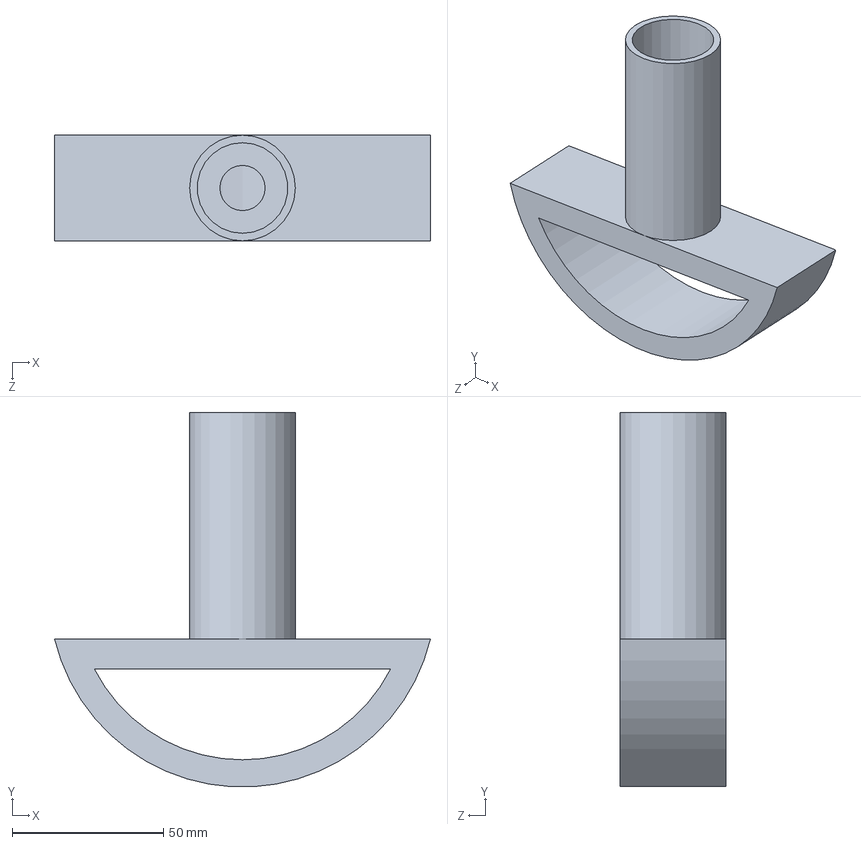
[picture p118: CAD file, 2024-01-19]
Teknofest Raporları/Kurtarma sistemi Solidworks çizimleri/Gövde .SLDPRT
124.4 x 123.9 x 35.0 mm
