MertHayla/Teknofest-tasarim-raporlari/Teknofest Raporları/Kurtarma sistemi Solidworks çizimleri/FaydalıYükKurtarmaYay.SLDPRT

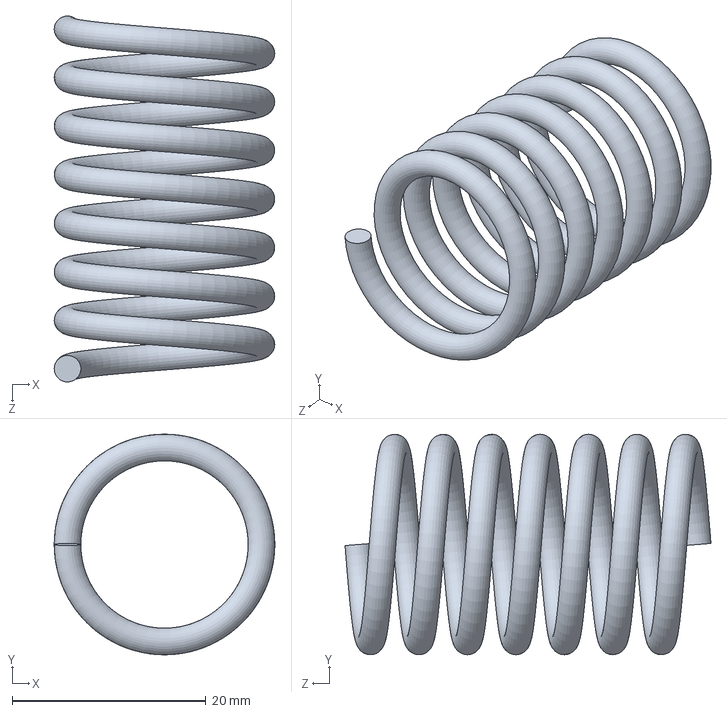
[picture p119: CAD file, 2024-01-19]
Teknofest Raporları/Kurtarma sistemi Solidworks çizimleri/FaydalıYükKurtarmaYay.SLDPRT
22.7 x 22.7 x 37.7 mm
