MertHayla/Teknofest-tasarim-raporlari/Teknofest Raporları/Kurtarma sistemi Solidworks çizimleri/Kurtarma Gövdesi 2 .SLDPRT

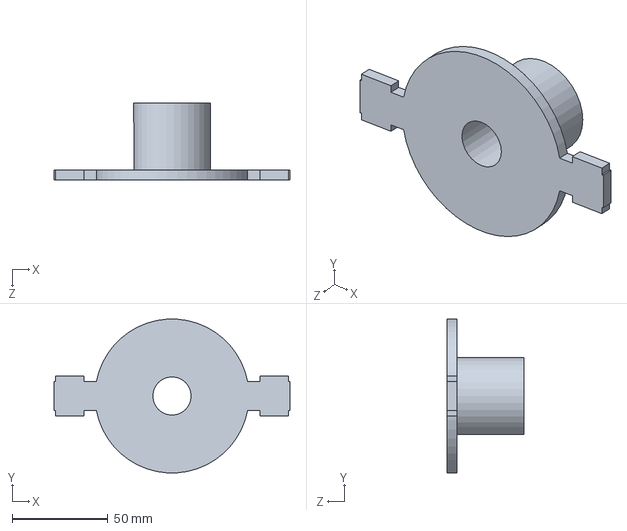
[picture p120: CAD file, 2024-01-19]
Teknofest Raporları/Kurtarma sistemi Solidworks çizimleri/Kurtarma Gövdesi 2 .SLDPRT
123.2 x 80.3 x 40.0 mm
