MertHayla/Teknofest-tasarim-raporlari/Teknofest Raporları/Kurtarma sistemi Solidworks çizimleri/Kurtarma Gövdesi 1 .SLDPRT

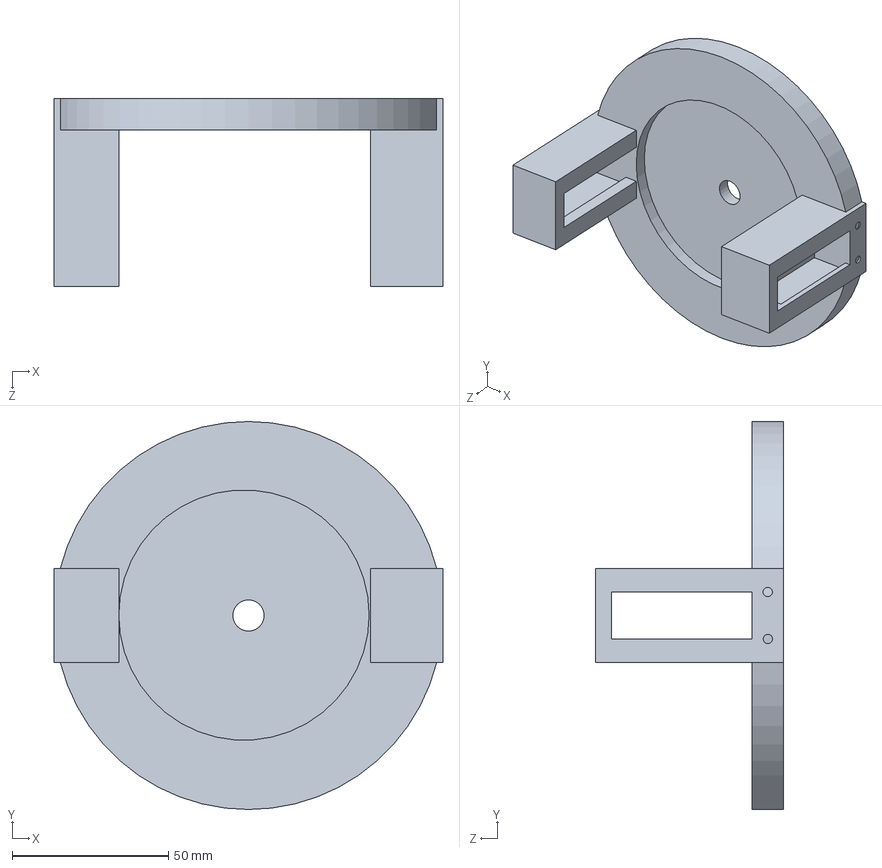
[picture p121: CAD file, 2024-01-19]
Teknofest Raporları/Kurtarma sistemi Solidworks çizimleri/Kurtarma Gövdesi 1 .SLDPRT
124.3 x 124.0 x 60.0 mm
