MertHayla/Teknofest-tasarim-raporlari/Teknofest Raporları/Kurtarma sistemi Solidworks çizimleri/Kurtarma Gövdesi 3 .SLDPRT

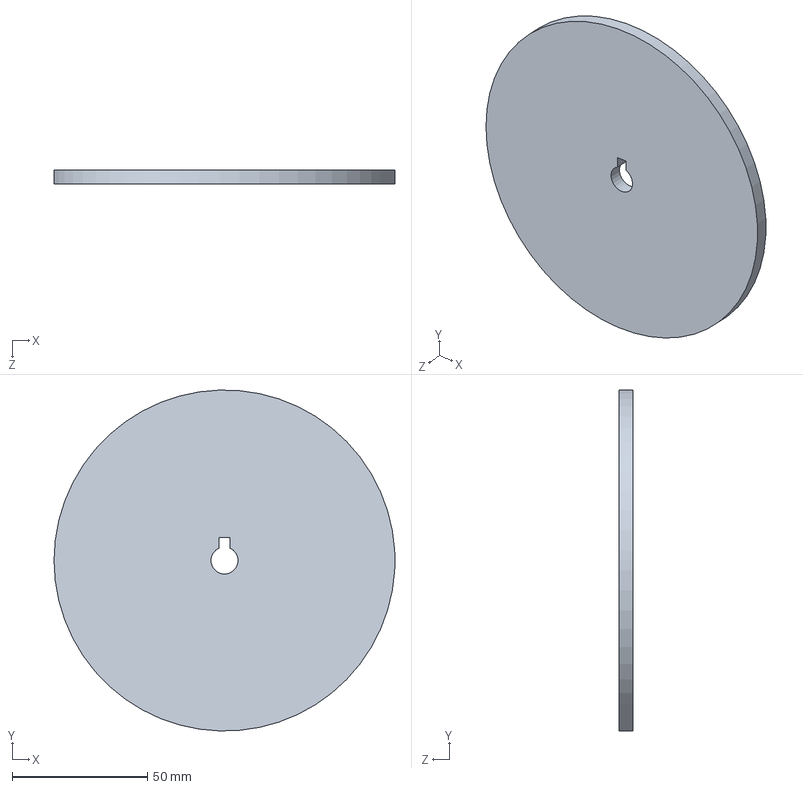
[picture p122: CAD file, 2024-01-19]
Teknofest Raporları/Kurtarma sistemi Solidworks çizimleri/Kurtarma Gövdesi 3 .SLDPRT
126.0 x 125.9 x 5.00 mm
